liveboxandy/ZX-Interface-1-Renewed-PLCC/ZX Interface 1 New Layout SMD PLCC.jpg

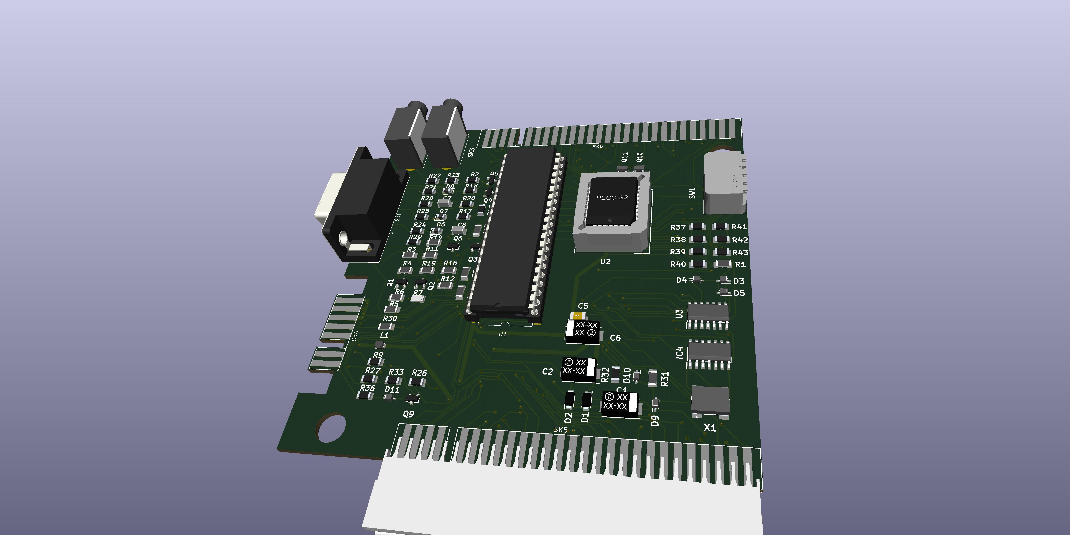
ZX Interface 1 New Layout SMD PLCC.jpg
