liveboxandy/ZX-Interface-1-Renewed-PLCC/ZX Interface 1 New Layout SMD PLCC.csv

Reference | Qty | Value | DNP | Exclude from BOM | Exclude from Board | Exclude from Simulation | Exclude from Position Files | Footprint | Datasheet
C1,C2,C6 | 3 | 47uF 16V |  |  |  |  | ${EXCLUDE_FROM_POS_FILES} | MOD:CAPPM7343X310N | http://www.vishay.com/docs/40002/293d.pdf
C5 | 1 | 47nF |  |  |  |  | ${EXCLUDE_FROM_POS_FILES} | MOD:C1206 | https://componentsearchengine.com/Datasheets/1/C1206C473K5RACTU.pdf
C7,C8 | 2 | 330pF |  |  |  |  | ${EXCLUDE_FROM_POS_FILES} | MOD:CAPC3317X75N | https://componentsearchengine.com/Datasheets/1/C3216C0G2J331J060AA.pdf
D1,D2 | 2 | SS2FH6 |  |  |  |  | ${EXCLUDE_FROM_POS_FILES} | MOD:SODFL3718X108N | http://www.vishay.com/docs/87731/ss2fh6.pdf
D3,D4,D5,D9,D10,D11 | 6 | 1N4148 |  |  |  |  | ${EXCLUDE_FROM_POS_FILES} | MOD:SODFL2512X90N | https://assets.nexperia.com/documents/data-sheet/1N4148_1N4448.pdf,https://www.diodes.com/assets/Datasheets/BAV16W_1N4148W.pdf
D6,D7,D8 | 3 | BZY55C4V3 |  |  |  |  | ${EXCLUDE_FROM_POS_FILES} | MOD:DIOC2012X85N | https://www.taiwansemi.com/assets/uploads/datasheet/BZY55C2V4%20SERIES_E2301.pdf
IC4 | 1 | SN74HCU04DR |  |  |  |  | ${EXCLUDE_FROM_POS_FILES} | MOD:SOIC127P600X175-14N | https://www.ti.com/lit/ds/symlink/sn74hcu04.pdf?ts=1600065682411
L1 | 1 | 22uH 0.41A |  |  |  |  | ${EXCLUDE_FROM_POS_FILES} | MOD:LQH2MCN100K02L | https://psearch.en.murata.com/inductor/product/LQH2MPN220MGR%23.html
Q1,Q2,Q4,Q5 | 4 | BC807-40 |  |  |  |  | ${EXCLUDE_FROM_POS_FILES} | MOD:SOT95P230X110-3N | https://assets.nexperia.com/documents/data-sheet/BC807_SER.pdf
Q3,Q6,Q9 | 3 | BC850C |  |  |  |  | ${EXCLUDE_FROM_POS_FILES} | MOD:BC850C215 | https://assets.nexperia.com/documents/data-sheet/BC849_BC850.pdf
Q10,Q11 | 2 | SST3904 |  |  |  |  | ${EXCLUDE_FROM_POS_FILES} | MOD:SOT95P240X120-3N | https://fscdn.rohm.com/en/products/databook/datasheet/discrete/transistor/bipolar/sst3904hzg-e.pdf
R1,R3,R5,R11,R14,R19,R31 | 7 | 1K0 |  |  |  |  | ${EXCLUDE_FROM_POS_FILES} | MOD:RESC3216X60N | http://componentsearchengine.com/Datasheets/1/CRCW12061K00FKEAC.pdf
R2,R22,R23 | 3 | 330R |  |  |  |  | ${EXCLUDE_FROM_POS_FILES} | MOD:RESC3116X65N
R4,R6,R8,R16 | 4 | 3K9 |  |  |  |  | ${EXCLUDE_FROM_POS_FILES} | MOD:RESC3216X60N | http://www.vishay.com/docs/20035/dcrcwe3.pdf
R7 | 1 | 47R |  |  |  |  | ${EXCLUDE_FROM_POS_FILES} | MOD:RCC1206_e3 | https://www.vishay.com/docs/20066/rcce3.pdf
R9,R21,R25,R26,R27,R33,R36,R37,R38,R39,R40,R41,R42,R43 | 14 | 10K |  |  |  |  | ${EXCLUDE_FROM_POS_FILES} | MOD:RESC3116X65N | http://www.te.com/commerce/DocumentDelivery/DDEController?Action=showdoc
R10 | 1 | 2K2 |  |  |  |  | ${EXCLUDE_FROM_POS_FILES} | MOD:RESC3216X60N | http://www.vishay.com/docs/20035/dcrcwe3.pdf
R12,R15 | 2 | 12K |  |  |  |  | ${EXCLUDE_FROM_POS_FILES} | MOD:RESC3216X60N | https://componentsearchengine.com/Datasheets/1/CRCW120612K4FKEAC.pdf
R13,R18,R32 | 3 | 680R |  |  |  |  | ${EXCLUDE_FROM_POS_FILES} | MOD:RESC3116X65N
R17,R20 | 2 | 2K7 |  |  |  |  | ${EXCLUDE_FROM_POS_FILES} | MOD:RESC3116X65N
R24 | 1 | 4K7 |  |  |  |  | ${EXCLUDE_FROM_POS_FILES} | MOD:RESC3116X65N | http://www.te.com/commerce/DocumentDelivery/DDEController?Action=showdoc
R28,R29 | 2 | 6K8 |  |  |  |  | ${EXCLUDE_FROM_POS_FILES} | MOD:RESC3116X65N | https://componentsearchengine.com/Datasheets/1/CRG1206F6K8.pdf
R30 | 1 | 270R |  |  |  |  | ${EXCLUDE_FROM_POS_FILES} | MOD:RESC3216X60N | https://componentsearchengine.com/Datasheets/1/CRCW1206270RFKEA.pdf
SK1 | 1 | DE9_Receptacle |  |  |  |  | ${EXCLUDE_FROM_POS_FILES} | MOD:DSUB-9_Female_Horizontal_P2.77x2.84mm_EdgePinOffset4.94mm_Housed_MountingHolesOffset7.48mm | ~
SK2,SK3 | 2 | MJ-3502N |  |  |  |  | ${EXCLUDE_FROM_POS_FILES} | MOD:MJ3502N | https://www.cui.com/product/resource/mj-3502n.pdf
SK4 | 1 | Microdrive |  |  |  |  | ${EXCLUDE_FROM_POS_FILES} | MOD:ZX_MD_Edge_Connector
SK5 | 1 | ZX Spectrum |  |  |  |  | ${EXCLUDE_FROM_POS_FILES} | MOD:ZX_Spectrum_BUS_Edge_Connector
SK6 | 1 | ZX Expansion |  |  |  |  | ${EXCLUDE_FROM_POS_FILES} | MOD:ZX_Expansion_BUS_Edge_Connector
SW1 | 1 | SW_DIP_x05 |  |  |  |  | ${EXCLUDE_FROM_POS_FILES} | MOD:A6FR5104 | https://omronfs.omron.com/en_US/ecb/products/pdf/en-a6fr.pdf
U1 | 1 | LA15-302 |  |  |  |  | ${EXCLUDE_FROM_POS_FILES} | MOD:DIP-40_W15.24mm | LA 15-302 Custom ULA
U2 | 1 | SST39SF040 |  |  |  |  | ${EXCLUDE_FROM_POS_FILES} | MOD:MC32PLCC | http://ww1.microchip.com/downloads/en/DeviceDoc/20005022C.pdf
U3 | 1 | 74LS27 |  |  |  |  | ${EXCLUDE_FROM_POS_FILES} | MOD:SOIC127P600X175-14N | http://www.ti.com/lit/gpn/SN74LS27
X1 | 1 | 8Mhz |  |  |  |  | ${EXCLUDE_FROM_POS_FILES} | MOD:830202129201 | https://www.we-online.com/catalog/datasheet/830202129201.pdf
