liveboxandy/ZX-Interface-1-Renewed-PLCC/STPS/SN74HCU04DR.stp

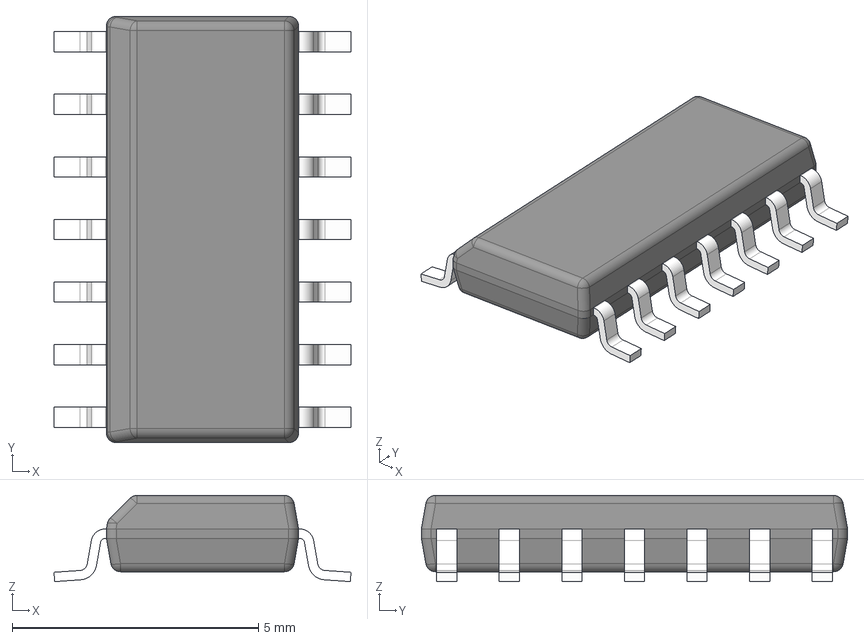
[picture p3: CAD file, 2026-10-28]
STPS/SN74HCU04DR.stp
6.03 x 8.65 x 1.75 mm
BODY-SO
LEAD-SO x 14
PIN1-ID
