liveboxandy/ZX-Interface-1-Renewed-PLCC/ZX Interface 1 New Layout SMD PLCC.step

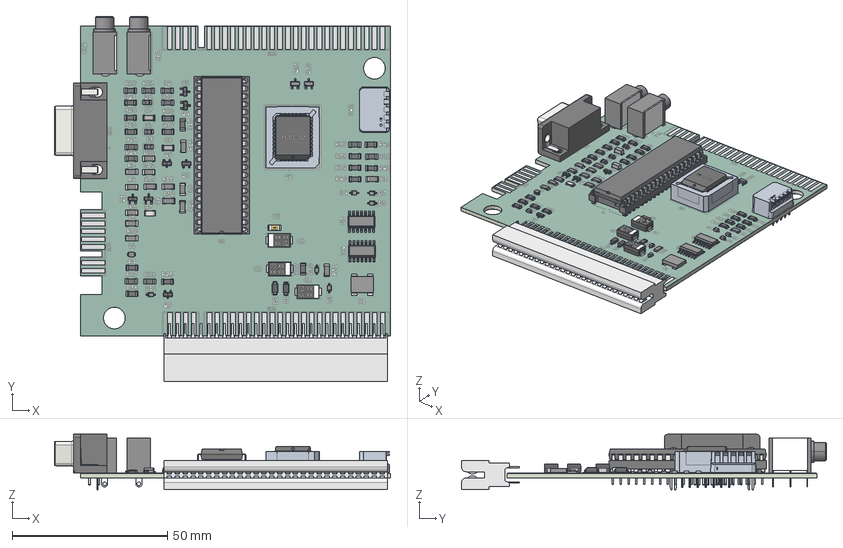
[picture p4: CAD file, 2026-10-28]
ZX Interface 1 New Layout SMD PLCC.step
108.4 x 117.7 x 17.9 mm
term1 x 28
term2 x 28
BODY-SO x 2
LEAD-SO x 28
PIN1-ID x 2
D25-CRCW1206 e3 x 15
SOT23 lower body x 7
SOT23 Lead x 21
SOT23 Upper body x 7
C-5435802-4
CCS_CCSTDNOS_1206_L3.40W1.80T1.75B0.75
PinKIdent x 6
PinK x 6
PinA x 6
DIP-40_W15.24mm
DIP_40_W1524mm_Socket
C3216C0G1H104J160AE x 2
SMF Package x 2
MJ-3502N x 2
PinsArrayL x 2
FilletPinR x 2
293D D-CASE x 3
LQH2MCN120K02L
DSUB-9_Female_Horizontal_P2.77x2.84mm_EdgePinOffset4.94mm_Housed_ MountingHolesOffset7.48mm
Pins
ZX 2A3D_copper
ZX 2A3D_pad
ZX 2A3D_via
ZX 2A3D_silkscreen x 2
ZX 2A3D_soldermask x 2
ZX 2A3D_PCB
