liveboxandy/ZX-Interface-1-Renewed-PLCC/STPS/DSUB-9_Female_Horizontal_P2.77x2.84mm_EdgePinOffset4.94mm_Housed_MountingHolesOffset7.48mm.step

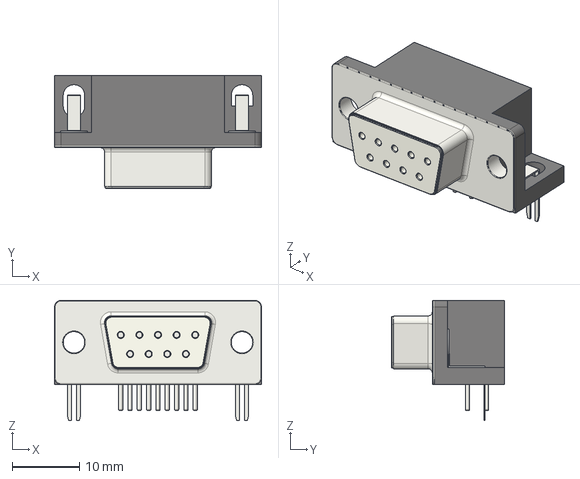
[picture p5: CAD file, 2026-10-28]
STPS/DSUB-9_Female_Horizontal_P2.77x2.84mm_EdgePinOffset4.94mm_Housed_MountingHolesOffset7.48mm.step
30.8 x 16.9 x 17.9 mm
