liveboxandy/ZX-Interface-1-Renewed-PLCC/STPS/PLCC32 Skt 1571540-1.stp

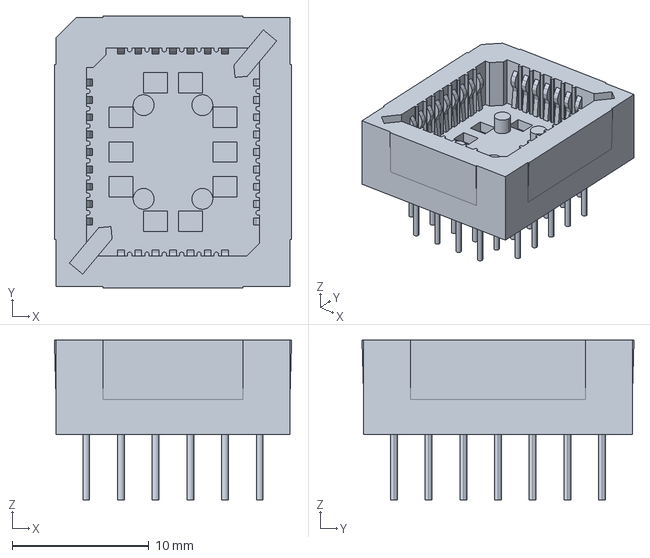
[picture p6: CAD file, 2026-10-28]
STPS/PLCC32 Skt 1571540-1.stp
17.4 x 19.9 x 11.7 mm
