liveboxandy/ZX-Interface-1-Renewed-PLCC/STPS/CRCW12062K20FKEA.stp

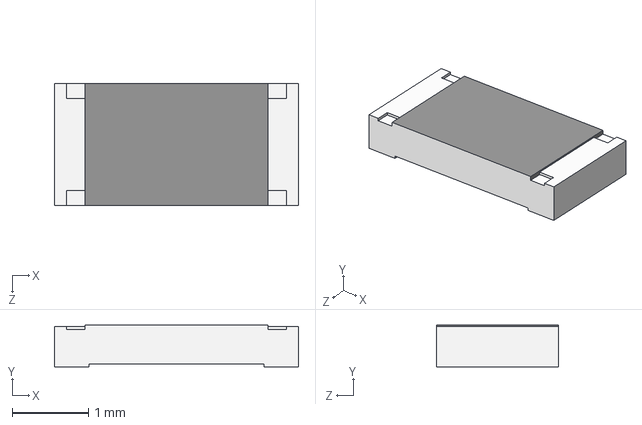
[picture p7: CAD file, 2026-10-28]
STPS/CRCW12062K20FKEA.stp
3.20 x 0.55 x 1.60 mm
