liveboxandy/ZX-Interface-1-Renewed-PLCC/STPS/DIP-40_W15.24mm.step

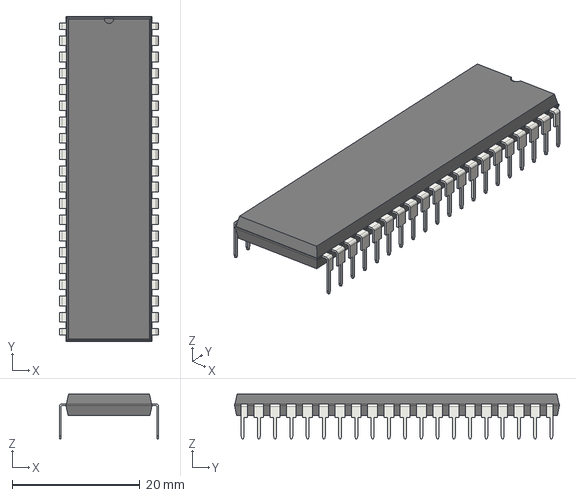
[picture p8: CAD file, 2026-10-28]
STPS/DIP-40_W15.24mm.step
15.5 x 50.8 x 6.98 mm
