liveboxandy/ZX-Interface-1-Renewed-PLCC/STPS/C3216C0G2J331J060AA.stp

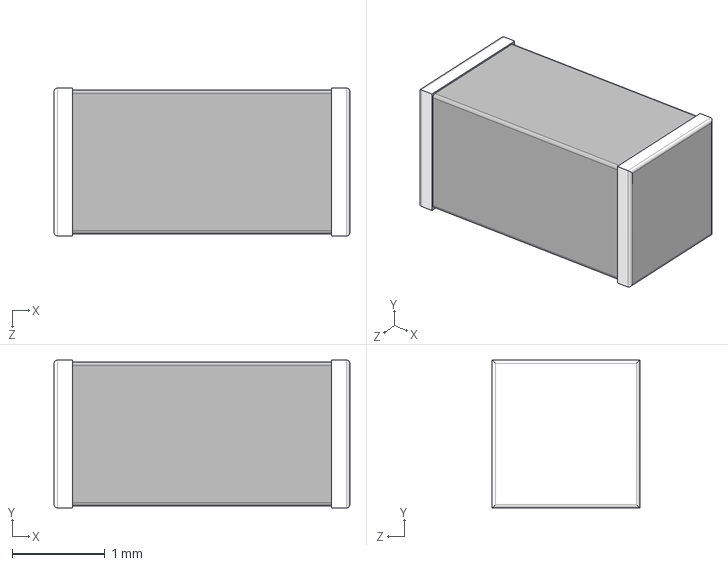
[picture p9: CAD file, 2026-10-28]
STPS/C3216C0G2J331J060AA.stp
3.20 x 1.60 x 1.60 mm
