liveboxandy/ZX-Interface-1-Renewed-PLCC/STPS/BAT20JFILM.stp

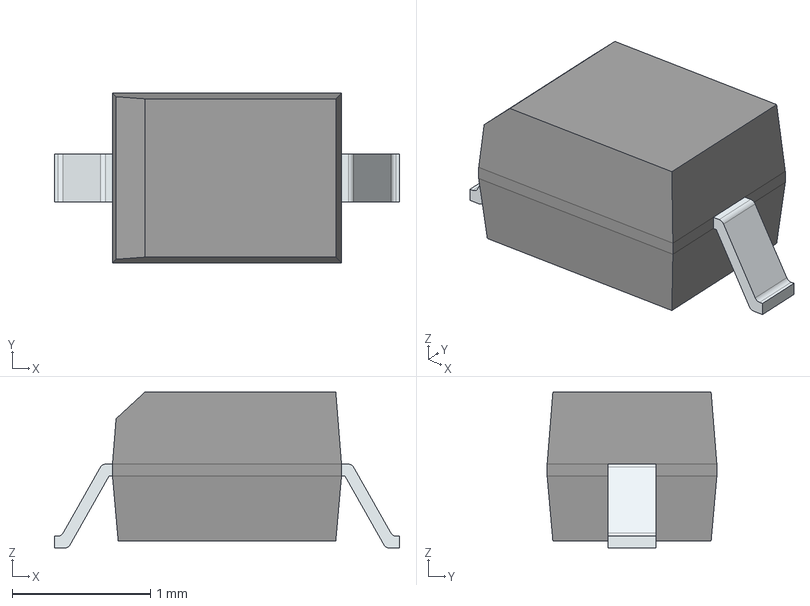
[picture p10: CAD file, 2026-10-28]
STPS/BAT20JFILM.stp
2.50 x 1.23 x 1.13 mm
FilletPinL
FilletPinR
