liveboxandy/ZX-Interface-1-Renewed-PLCC/STPS/SN74HCU04PW.stp

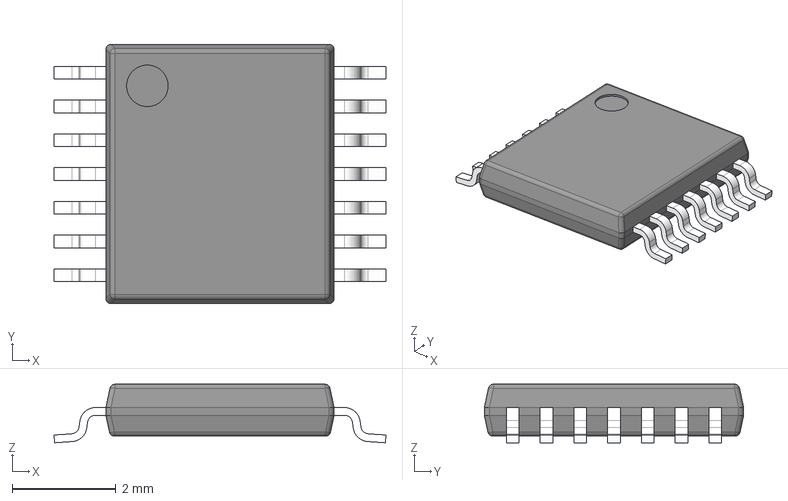
[picture p11: CAD file, 2026-10-28]
STPS/SN74HCU04PW.stp
6.40 x 5.00 x 1.13 mm
BODY-TSSOP
LEAD-TSSOP x 14
PIN1
