liveboxandy/ZX-Interface-1-Renewed-PLCC/STPS/SST39SF040-70-4C-PHE.stp

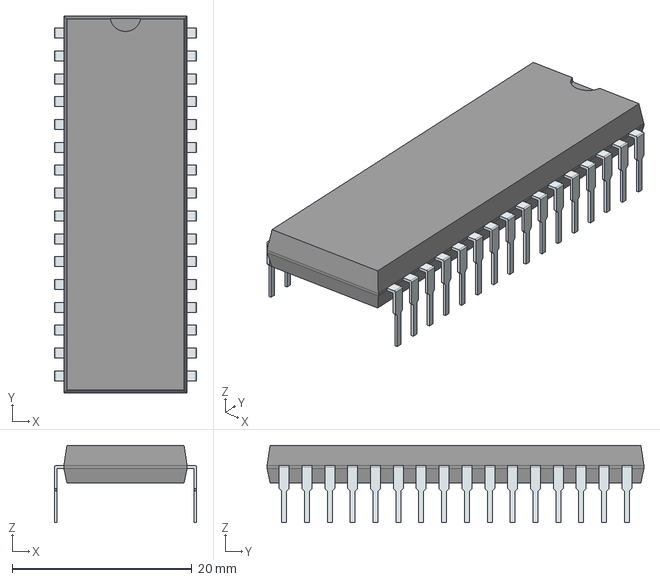
[picture p12: CAD file, 2026-10-28]
STPS/SST39SF040-70-4C-PHE.stp
15.8 x 41.9 x 8.58 mm
PinsArrayLR
