liveboxandy/ZX-Interface-1-Renewed-PLCC/STPS/CRGH1206F330R.stp

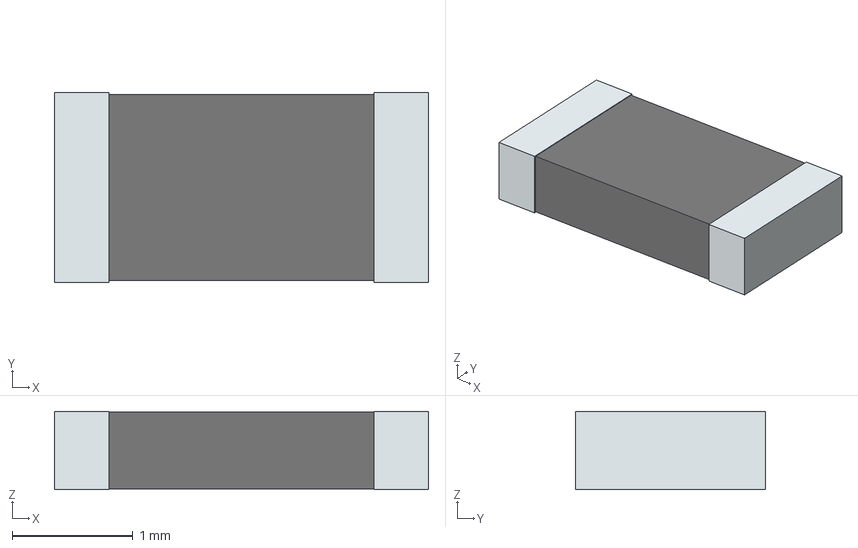
[picture p13: CAD file, 2026-10-28]
STPS/CRGH1206F330R.stp
3.10 x 1.57 x 0.65 mm
term1
term2
