liveboxandy/ZX-Interface-1-Renewed-PLCC/STPS/CRG1206F6K8.stp

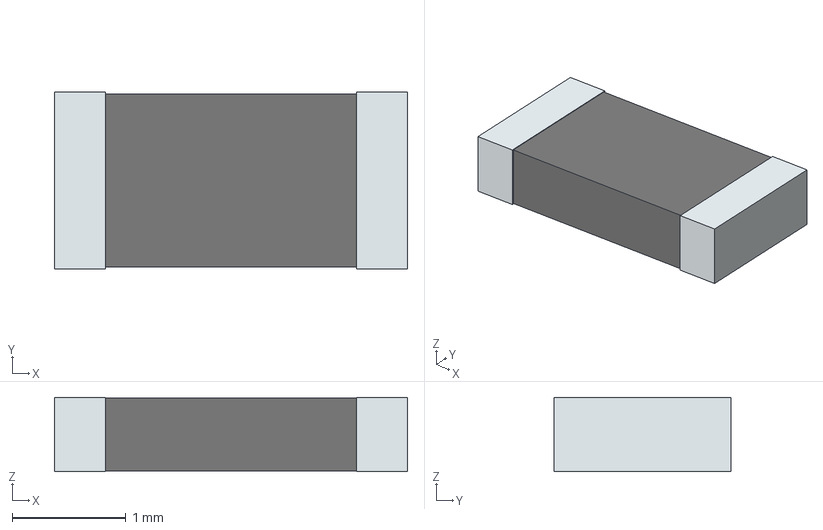
[picture p14: CAD file, 2026-10-28]
STPS/CRG1206F6K8.stp
3.10 x 1.55 x 0.65 mm
term1
term2
