liveboxandy/ZX-Interface-1-Renewed-PLCC/STPS/C1206C473K5RACTU.stp

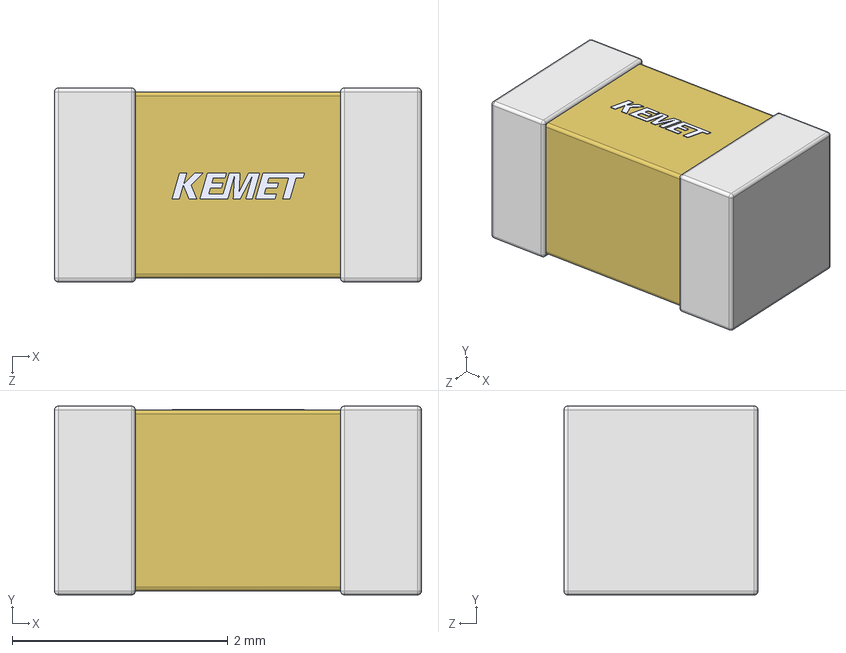
[picture p15: CAD file, 2026-10-28]
STPS/C1206C473K5RACTU.stp
3.40 x 1.75 x 1.80 mm
