liveboxandy/ZX-Interface-1-Renewed-PLCC/STPS/C1206C473J4REC7210.stp

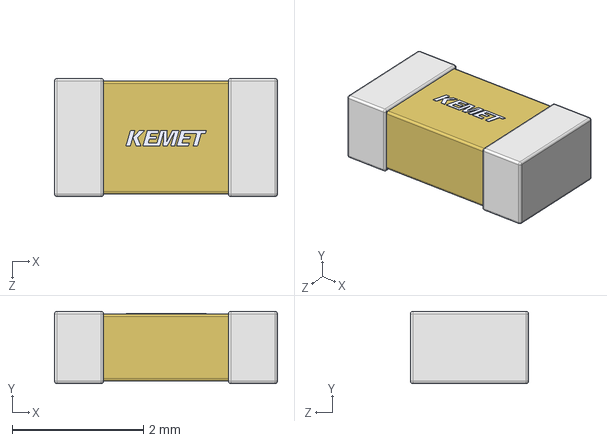
[picture p16: CAD file, 2026-10-28]
STPS/C1206C473J4REC7210.stp
3.40 x 1.10 x 1.80 mm
