liveboxandy/ZX-Interface-1-Renewed-PLCC/STPS/56 Way RightAngle.stp

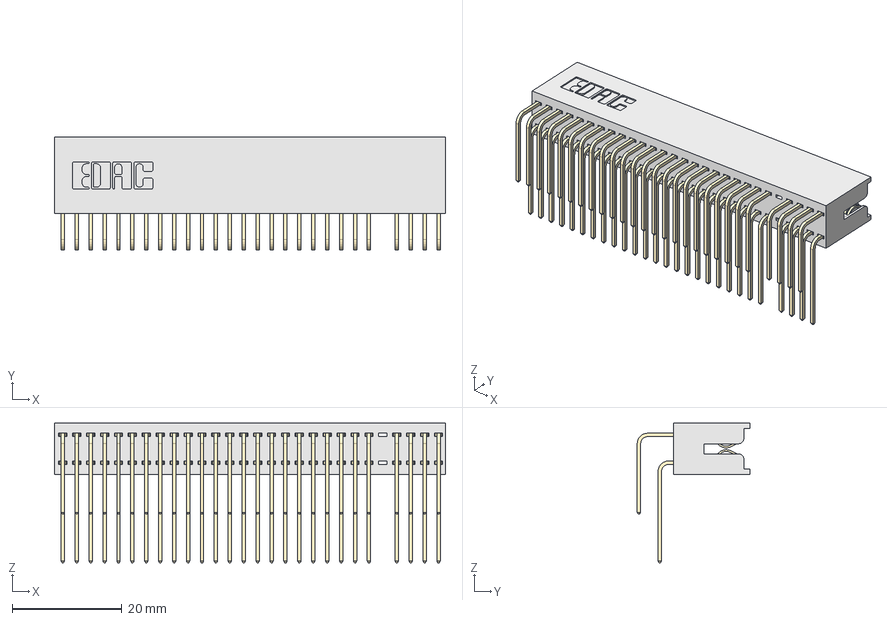
[picture p17: CAD file, 2026-10-28]
STPS/56 Way RightAngle.stp
71.4 x 20.6 x 25.5 mm
345-292-001_558 559 Tail - 020
345-292-001_559 Tail - 021
345-292-001_558 559 Tail - 021
345-292-001_558 559 Tail - 022
345-292-001_559 Tail - 022
345-292-001_559 Tail - 023
345-292-001_558 559 Tail - 023
345-292-001_559 Tail - 024
345-292-001_558 559 Tail - 024
345-292-001_558 559 Tail - 025
345-292-001_558 559 Tail - 026
345-292-001_558 559 Tail - 027
345-292-001_558 559 Tail - 028
345-292-001_558 559 Tail - 029
345-292-001_558 559 Tail - 030
345-292-001_558 559 Tail - 031
345-292-001_558 559 Tail - 032
345-292-001_558 559 Tail - 033
345-292-001_558 559 Tail - 034
345-292-001_558 559 Tail - 035
345-292-001_558 559 Tail - 036
345-292-001_558 559 Tail - 037
345-292-001_558 559 Tail - 038
345-292-001_558 559 Tail - 039
345-292-001_558 559 Tail - 040
345-292-001_558 559 Tail - 041
345-292-001_558 559 Tail - 042
345-292-001_558 559 Tail - 044
345-292-001_558 559 Tail - 045
345-292-001_558 559 Tail - 046
345-292-001_558 559 Tail - 047
345-292-001_559 Tail - 025
345-292-001_559 Tail - 026
345-292-001_559 Tail - 027
345-292-001_559 Tail - 028
345-292-001_559 Tail - 029
345-292-001_559 Tail - 030
345-292-001_559 Tail - 031
345-292-001_559 Tail - 032
345-292-001_559 Tail - 033
345-292-001_559 Tail - 034
345-292-001_559 Tail - 035
345-292-001_559 Tail - 036
345-292-001_559 Tail - 037
345-292-001_559 Tail - 038
345-292-001_559 Tail - 039
345-292-001_559 Tail - 040
345-292-001_559 Tail - 041
345-292-001_559 Tail - 042
345-292-001_559 Tail - 043
345-292-001_559 Tail - 045
345-292-001_559 Tail - 046
345-292-001_559 Tail - 047
345-292-001_559 Tail - 048
