liveboxandy/ZX-Interface-1-Renewed-PLCC/STPS/XM3B-0922-502.stp

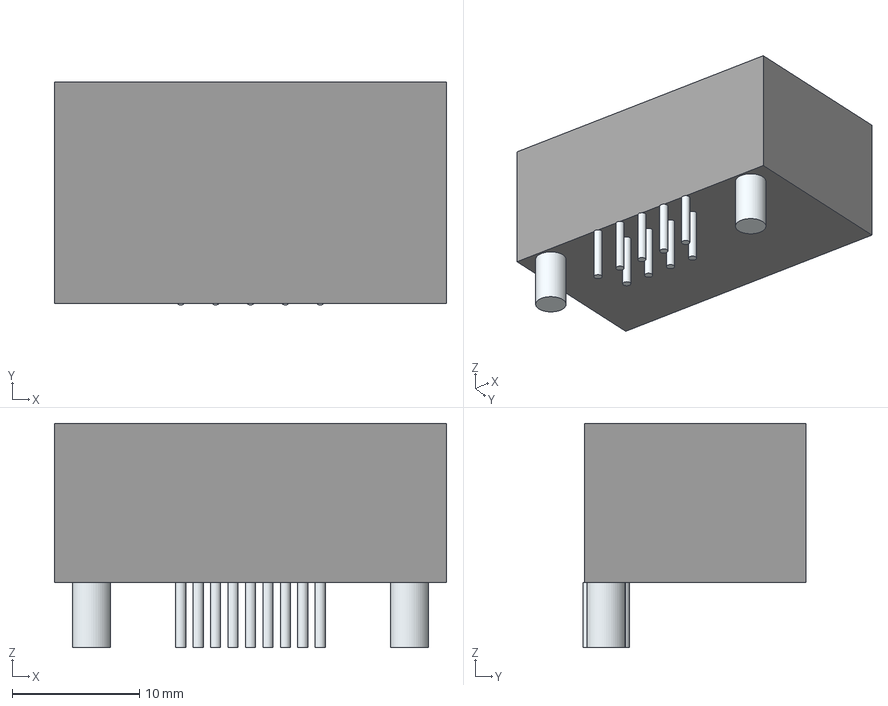
[picture p18: CAD file, 2026-10-28]
STPS/XM3B-0922-502.stp
30.8 x 17.5 x 17.6 mm
Leads
