liveboxandy/ZX-Interface-1-Renewed-PLCC/STPS/NE555DR.stp

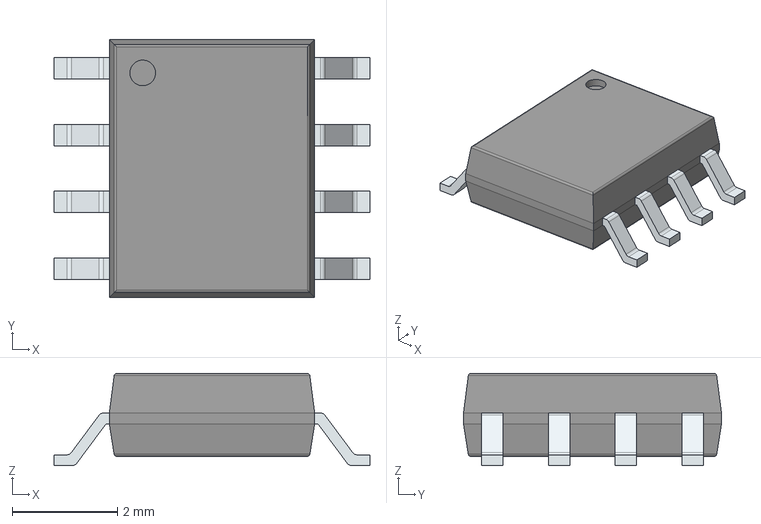
[picture p19: CAD file, 2026-10-28]
STPS/NE555DR.stp
6.00 x 4.90 x 1.75 mm
PinsArrayLR
