liveboxandy/ZX-Interface-1-Renewed-PLCC/STPS/SS2FH6-M3_H.stp

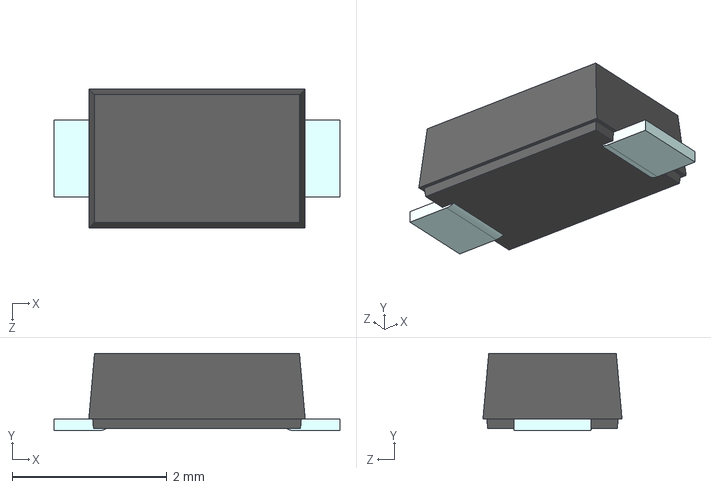
[picture p20: CAD file, 2026-10-28]
STPS/SS2FH6-M3_H.stp
3.70 x 1 x 1.80 mm
