liveboxandy/ZX-Interface-1-Renewed-PLCC/STPS/DIP-32_W15.24mm.step

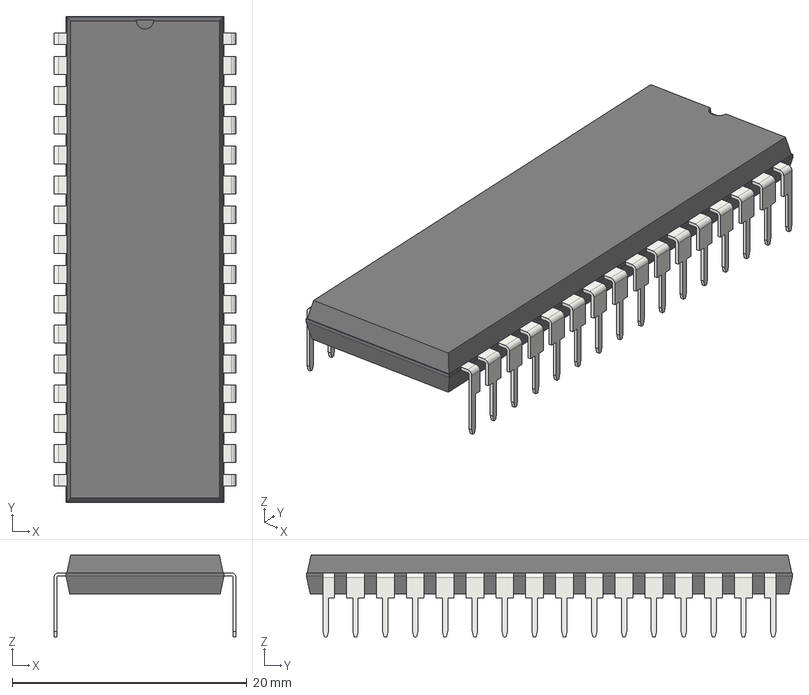
[picture p21: CAD file, 2026-10-28]
STPS/DIP-32_W15.24mm.step
15.5 x 41.4 x 6.98 mm
