liveboxandy/ZX-Interface-1-Renewed-PLCC/STPS/293D476X9016D2TE3.stp

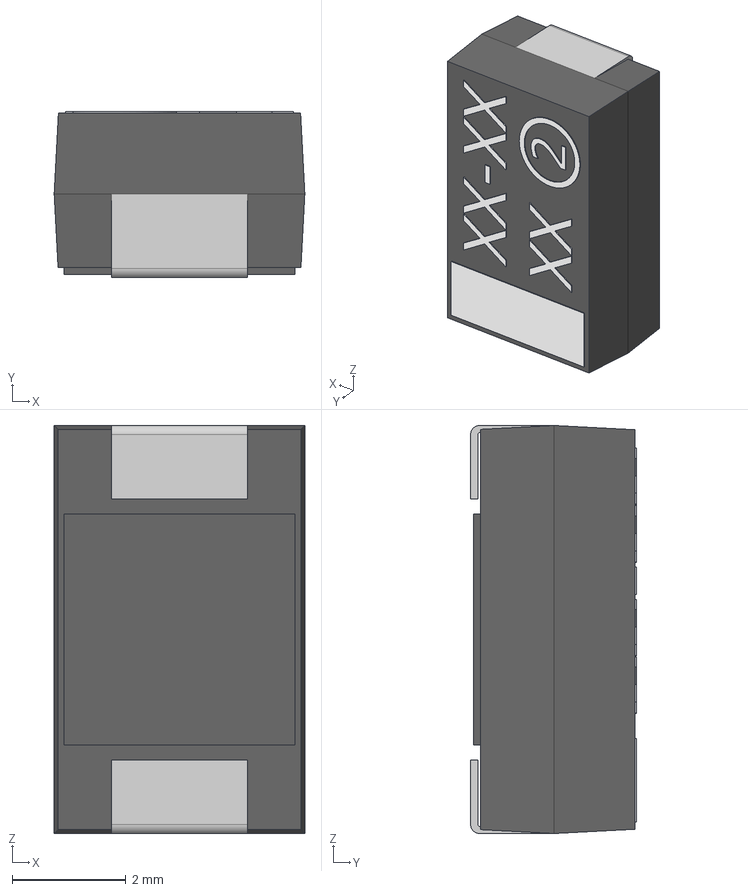
[picture p22: CAD file, 2026-10-28]
STPS/293D476X9016D2TE3.stp
4.42 x 2.92 x 7.19 mm
