liveboxandy/ZX-Interface-1-Renewed-PLCC/STPS/SST39SF040-70-4I-WHE-T.stp

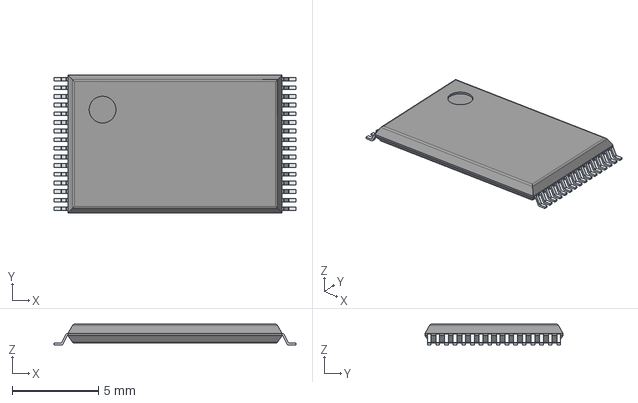
[picture p23: CAD file, 2026-10-28]
STPS/SST39SF040-70-4I-WHE-T.stp
14.0 x 8.00 x 1.20 mm
PinsArrayLR
