liveboxandy/ZX-Interface-1-Renewed-PLCC/STPS/BC807-40,215.stp

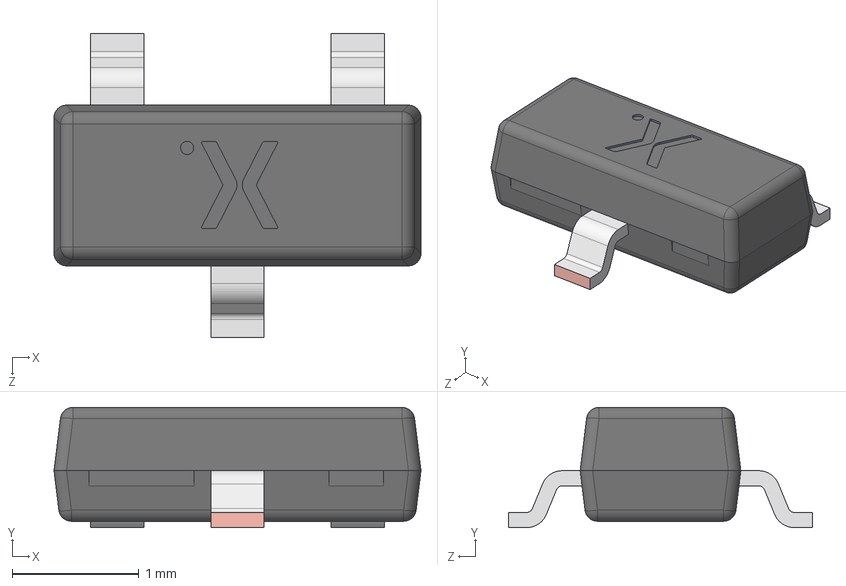
[picture p24: CAD file, 2026-10-28]
STPS/BC807-40,215.stp
2.90 x 0.95 x 2.40 mm
SOT23 lower body
SOT23 Lead x 3
SOT23 Upper body
