liveboxandy/ZX-Interface-1-Renewed-PLCC/STPS/SST3904HZGT116.stp

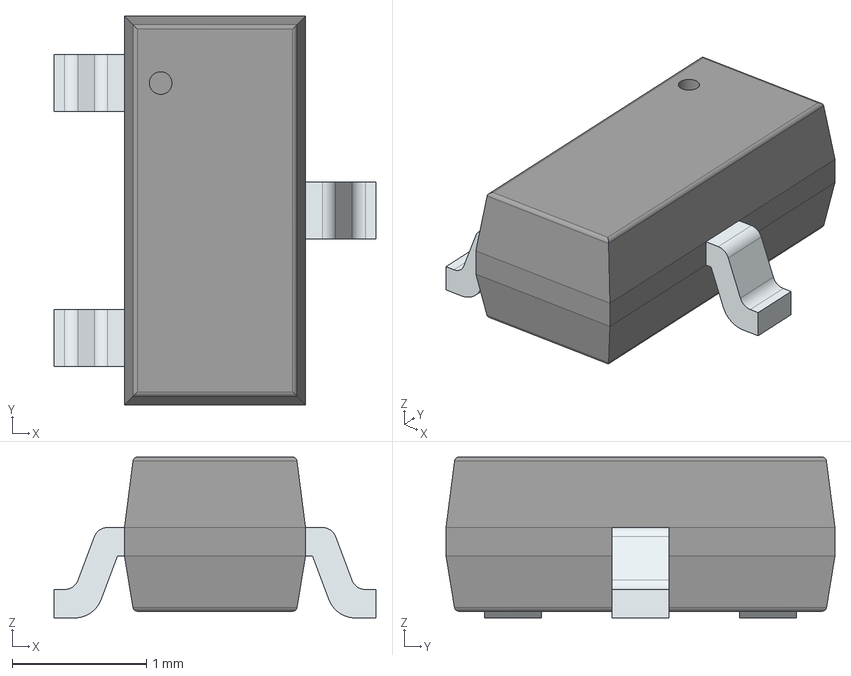
[picture p25: CAD file, 2026-10-28]
STPS/SST3904HZGT116.stp
2.40 x 2.90 x 1.20 mm
PinsArrayL
FilletPinR
