liveboxandy/ZX-Interface-1-Renewed-PLCC/STPS/LQH2MPN220MGRL.stp

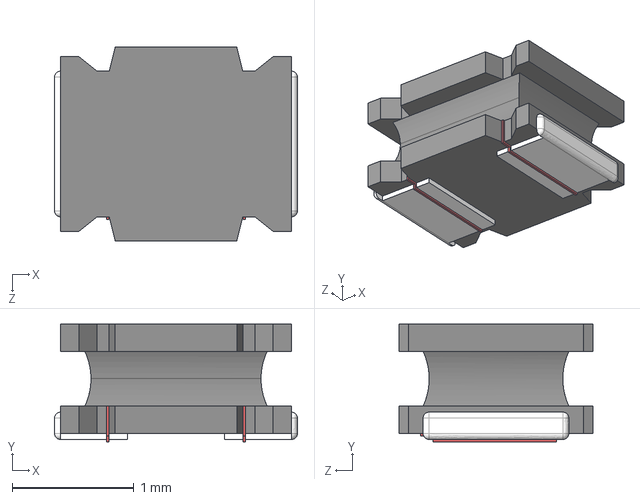
[picture p26: CAD file, 2026-10-28]
STPS/LQH2MPN220MGRL.stp
2.00 x 0.97 x 1.60 mm
