liveboxandy/ZX-Interface-1-Renewed-PLCC/STPS/DIP-40_W15.24mm_Socket.step

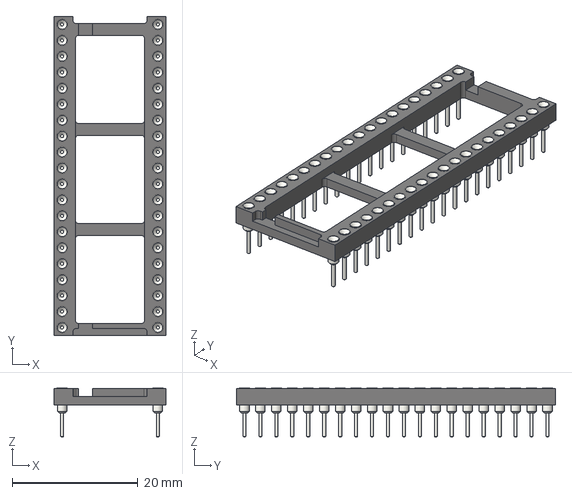
[picture p27: CAD file, 2026-10-28]
STPS/DIP-40_W15.24mm_Socket.step
17.8 x 50.8 x 7.79 mm
