liveboxandy/ZX-Interface-1-Renewed-PLCC/STPS/BZY55C4V3_RBG.stp

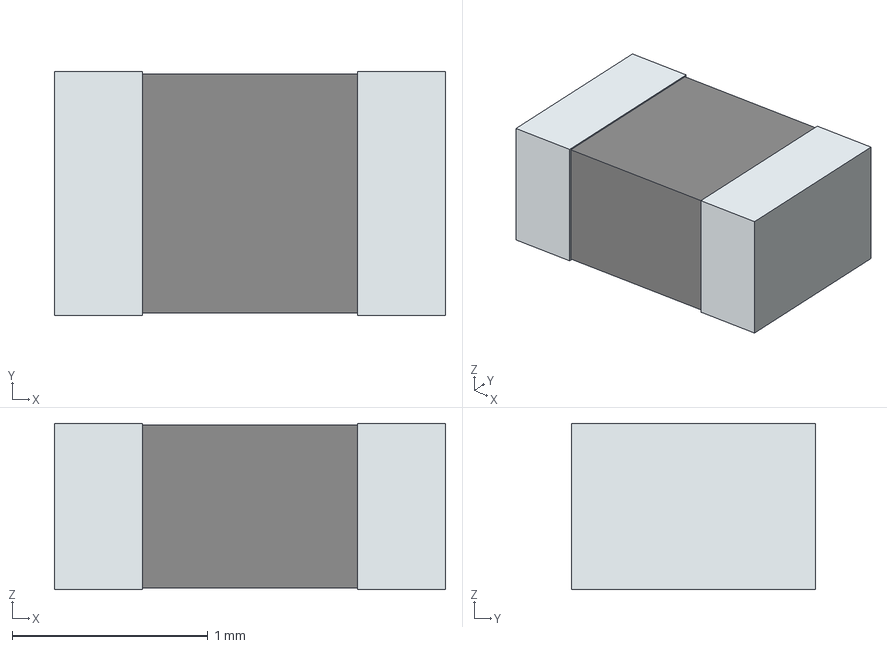
[picture p28: CAD file, 2026-10-28]
STPS/BZY55C4V3_RBG.stp
2.00 x 1.25 x 0.85 mm
term1
term2
