liveboxandy/ZX-Interface-1-Renewed-PLCC/STPS/56 Way Horizontal.stp

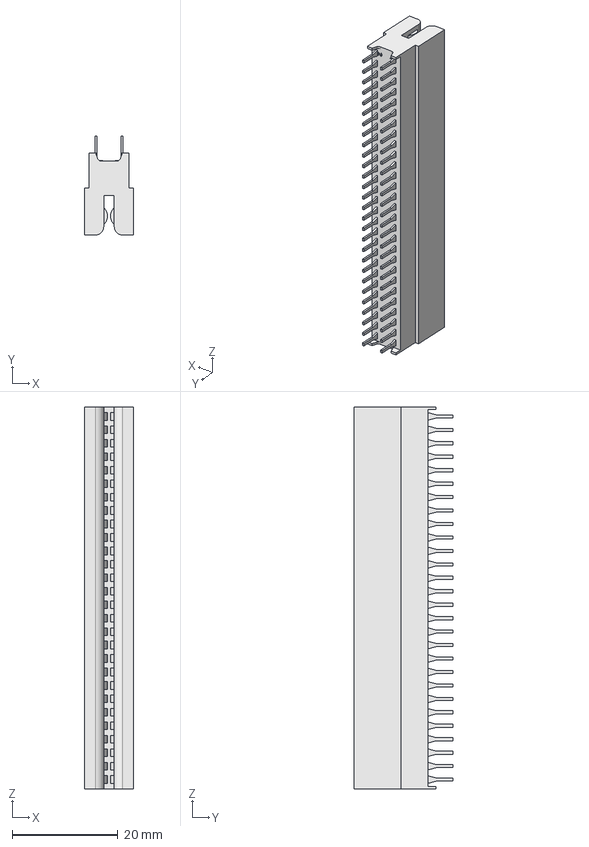
[picture p29: CAD file, 2026-10-28]
STPS/56 Way Horizontal.stp
9.35 x 18.7 x 72.1 mm
