liveboxandy/ZX-Interface-1-Renewed-PLCC/STPS/MJ-3502N.stp

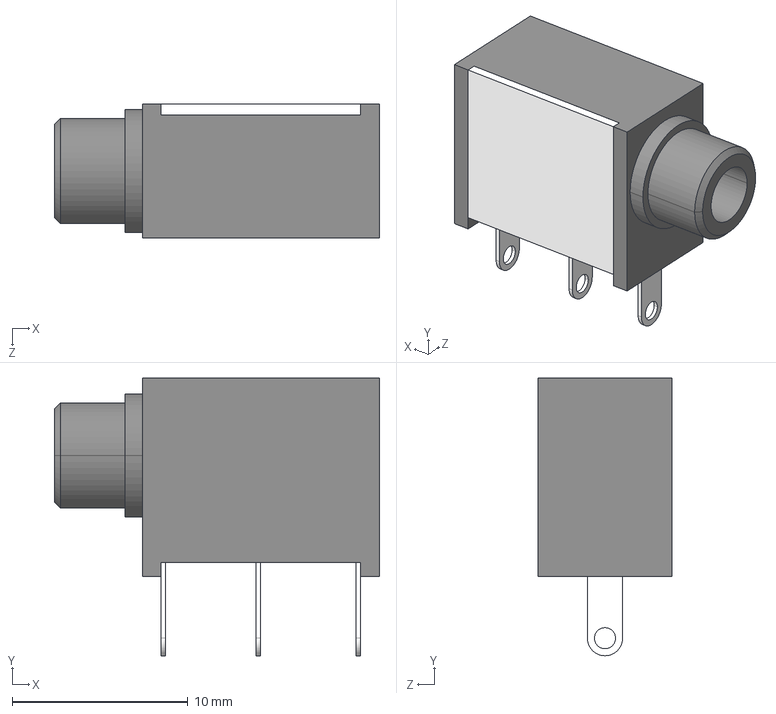
[picture p30: CAD file, 2026-10-28]
STPS/MJ-3502N.stp
18.5 x 15.8 x 7.60 mm
