liveboxandy/ZX-Interface-1-Renewed-PLCC/STPS/5 Position Piano A6FR.stp

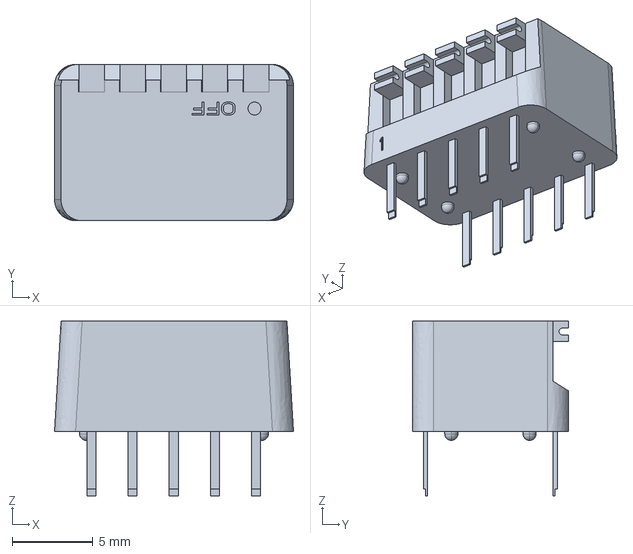
[picture p31: CAD file, 2026-10-28]
STPS/5 Position Piano A6FR.stp
14.8 x 9.66 x 10.8 mm
