liveboxandy/ZX-Interface-1-Renewed-PLCC/STPS/1N4148WS.stp

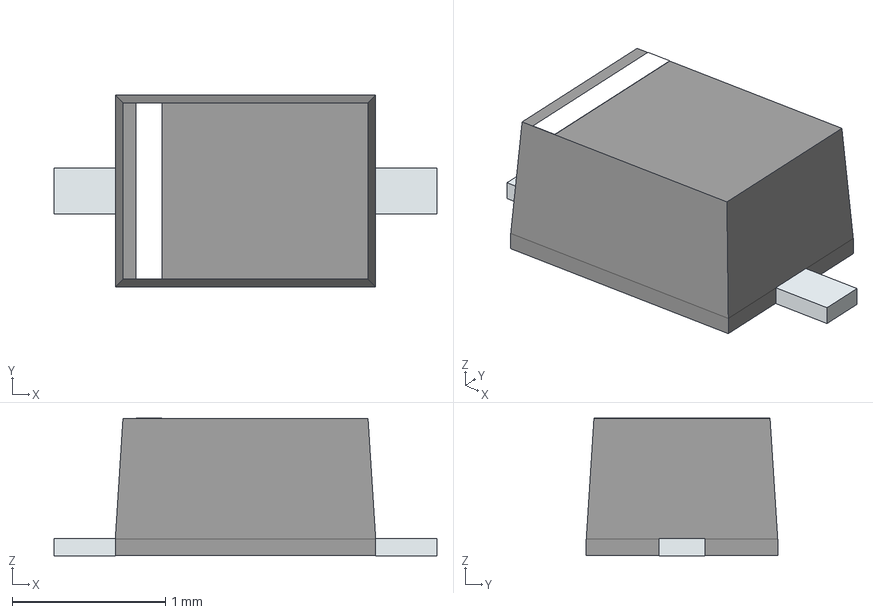
[picture p32: CAD file, 2026-10-28]
STPS/1N4148WS.stp
2.50 x 1.25 x 0.9 mm
PinKIdent
PinK
PinA
