liveboxandy/ZX-Interface-1-Renewed-PLCC/STPS/plcc32_p1-27_l14-05_w11-51.stp

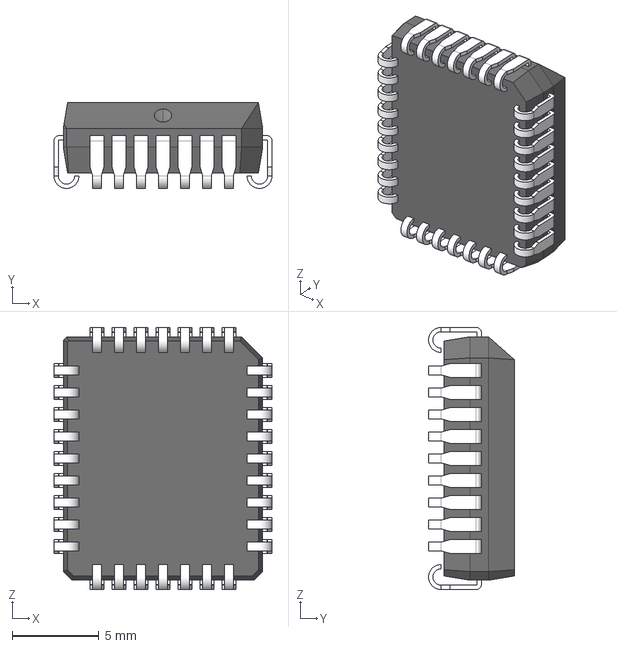
[picture p33: CAD file, 2026-10-28]
STPS/plcc32_p1-27_l14-05_w11-51.stp
12.6 x 4.96 x 15.1 mm
