liveboxandy/ZX-Interface-1-Renewed-PLCC/STPS/MC-32PLCC.stp

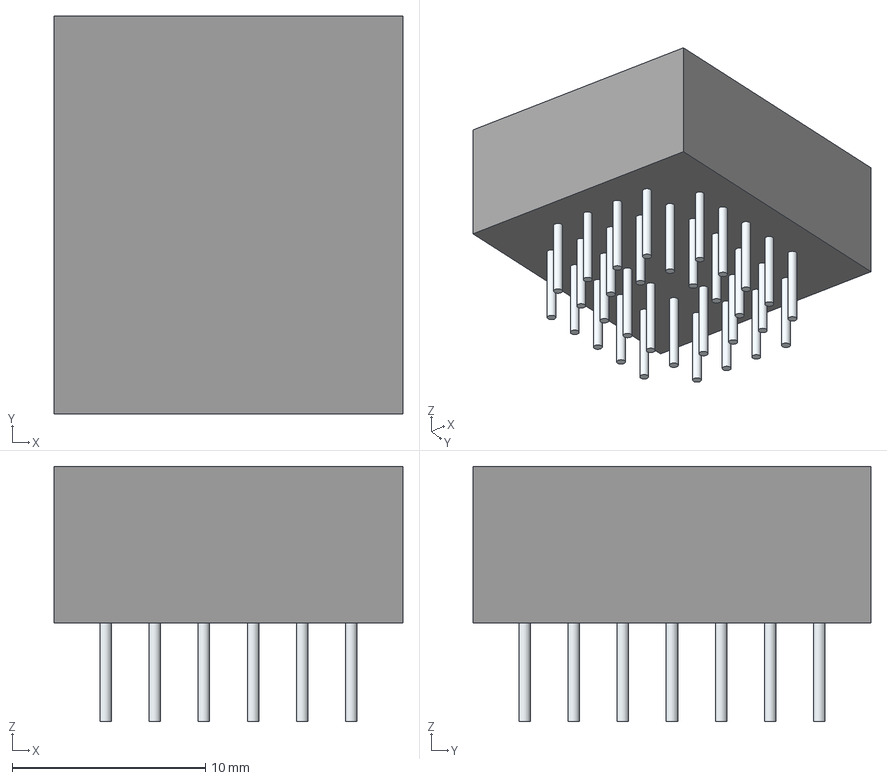
[picture p34: CAD file, 2026-10-28]
STPS/MC-32PLCC.stp
18.0 x 20.6 x 13.2 mm
Leads
