liveboxandy/ZX-Interface-1-Renewed-PLCC/STPS/DIP-32_W15.24mm_Socket.step

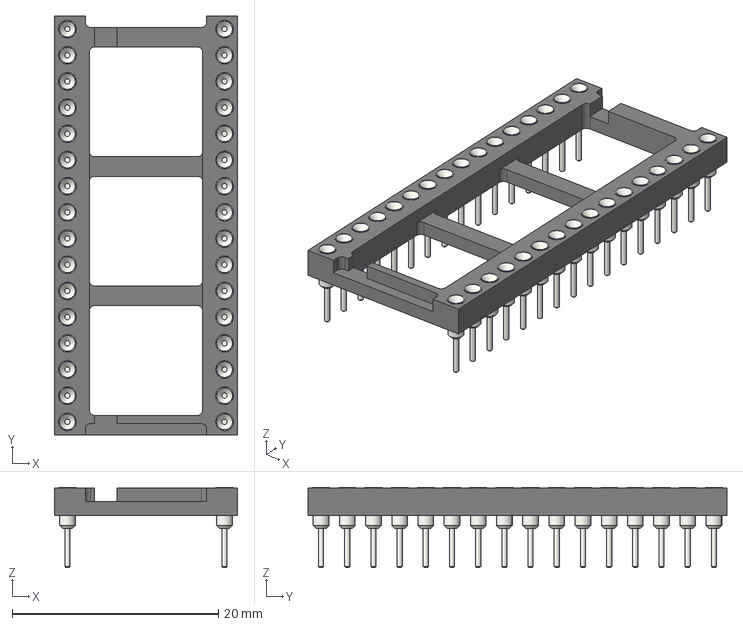
[picture p35: CAD file, 2026-10-28]
STPS/DIP-32_W15.24mm_Socket.step
17.8 x 40.6 x 7.79 mm
