liveboxandy/ZX-Interface-1-Renewed-PLCC/(list of files, cad)

Other CAD files:
STPS/CRGS1206J4K7.stp
STPS/CRG1206F10K.stp
STPS/CRGH1206F680R.stp
STPS/CRGH1206F2K7.stp
STPS/830202129201.stp
STPS/RCC120647R0FKEA.stp
