liveboxandy/ZX-Interface-1-Renewed-PLCC/ZX Interface 1 New Layout SMD PLCC.pdf

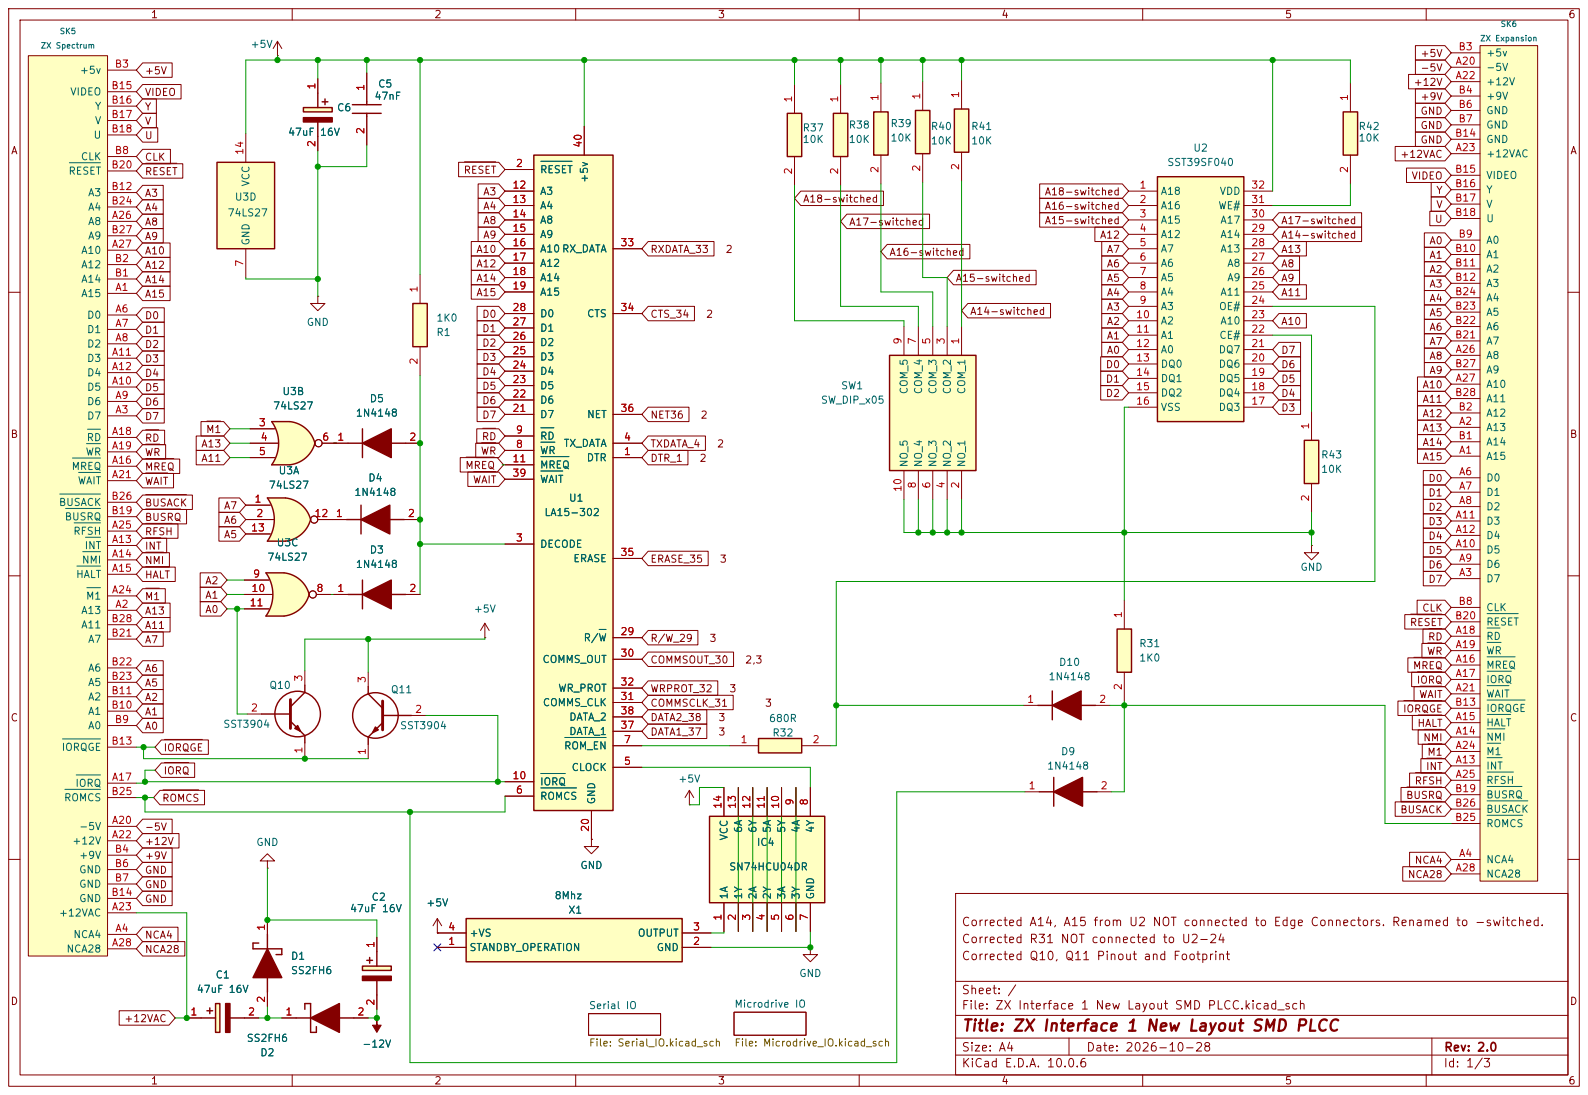
[picture p36: page 1]

IORQ
IORQGE NMI HALT WAIT

Corrected A14, A15 from U2 NOT connected to Edge Connectors. Renamed to -switched. Microdrive IO

Corrected R31 NOT connected to U2-24
Corrected Q10, Q11 Pinout and Footprint

Sheet: /
File: ZX Interface 1 New Layout SMD PLCC.kicad_sch
Title: ZX Interface 1 New Layout SMD PLCC
KiCad E.D.A. 10.0.6

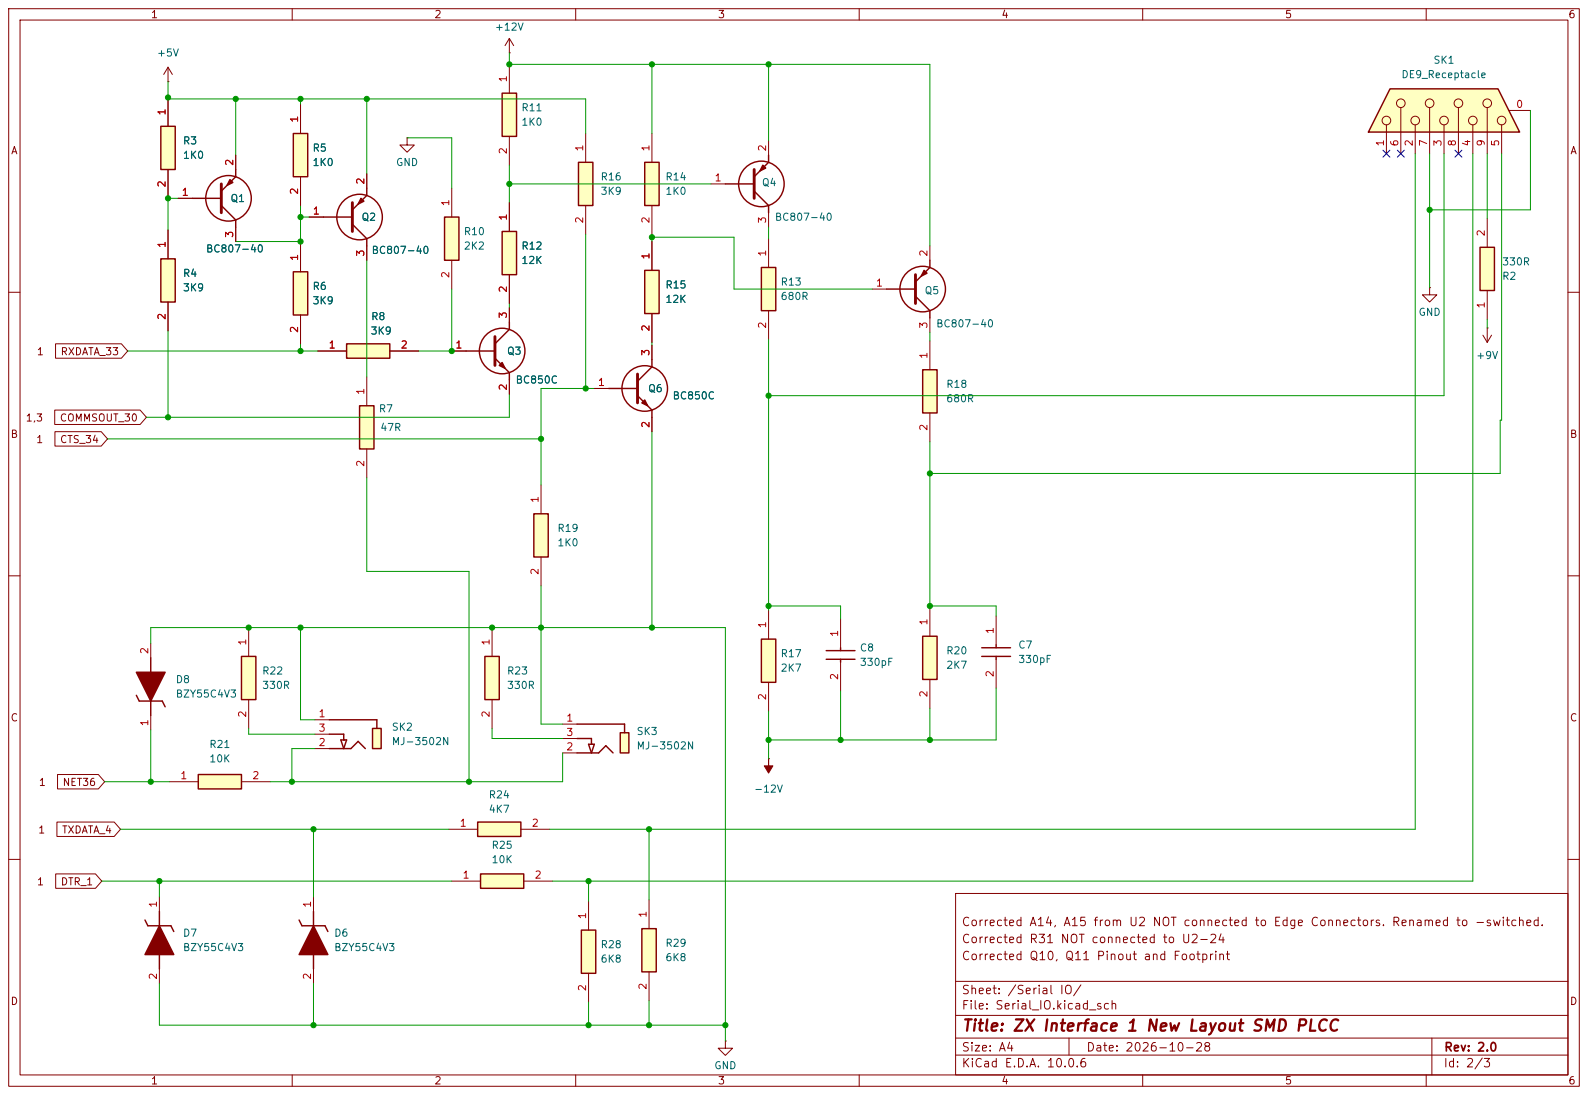
[picture p37: page 2]

Corrected A14, A15 from U2 NOT connected to Edge Connectors. Renamed to -switched.
Corrected R31 NOT connected to U2-24
Corrected Q10, Q11 Pinout and Footprint

Sheet: /Serial IO/
File: Serial_IO.kicad_sch
Title: ZX Interface 1 New Layout SMD PLCC

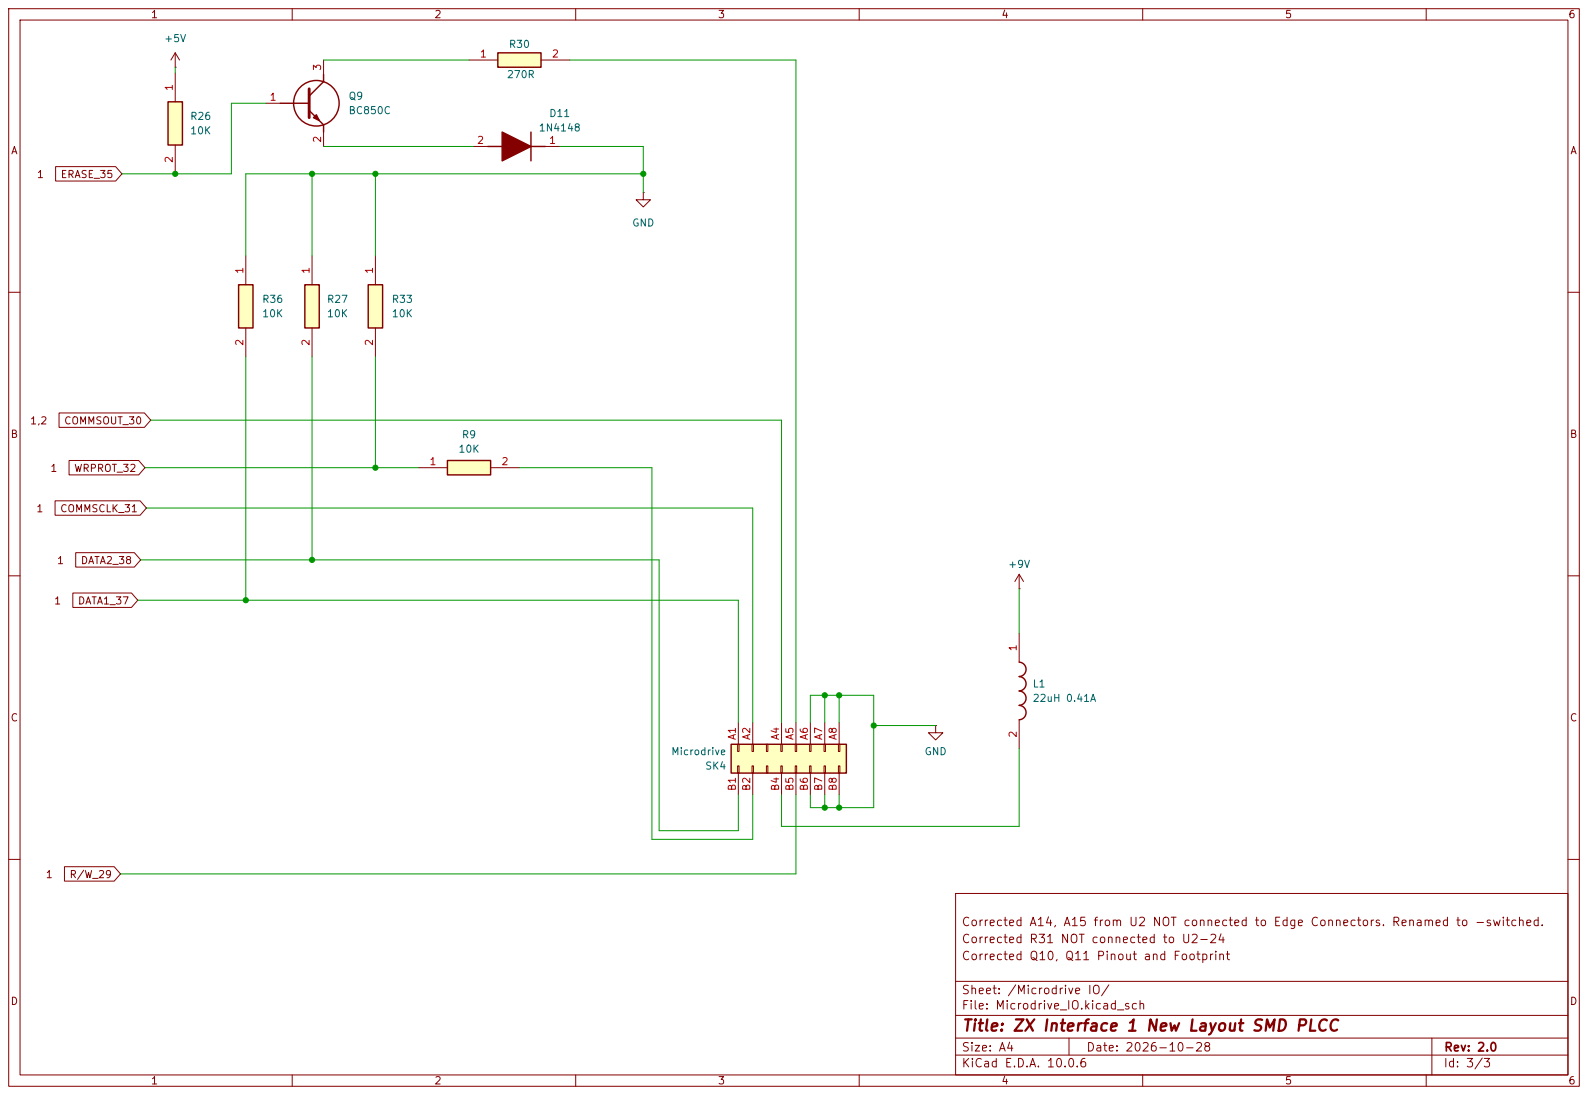
[picture p38: page 3]
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

Sheet: /Microdrive IO/
File: Microdrive_IO.kicad_sch
Title: ZX Interface 1 New Layout SMD PLCC
