liveboxandy/ZX-Interface-1-Renewed-PLCC/ZX Interface 1 New Layout SMD PLCC.kicad_pcb

## KiCad design ZX Interface 1 New Layout SMD PLCC.kicad_pcb (2026-10-28)

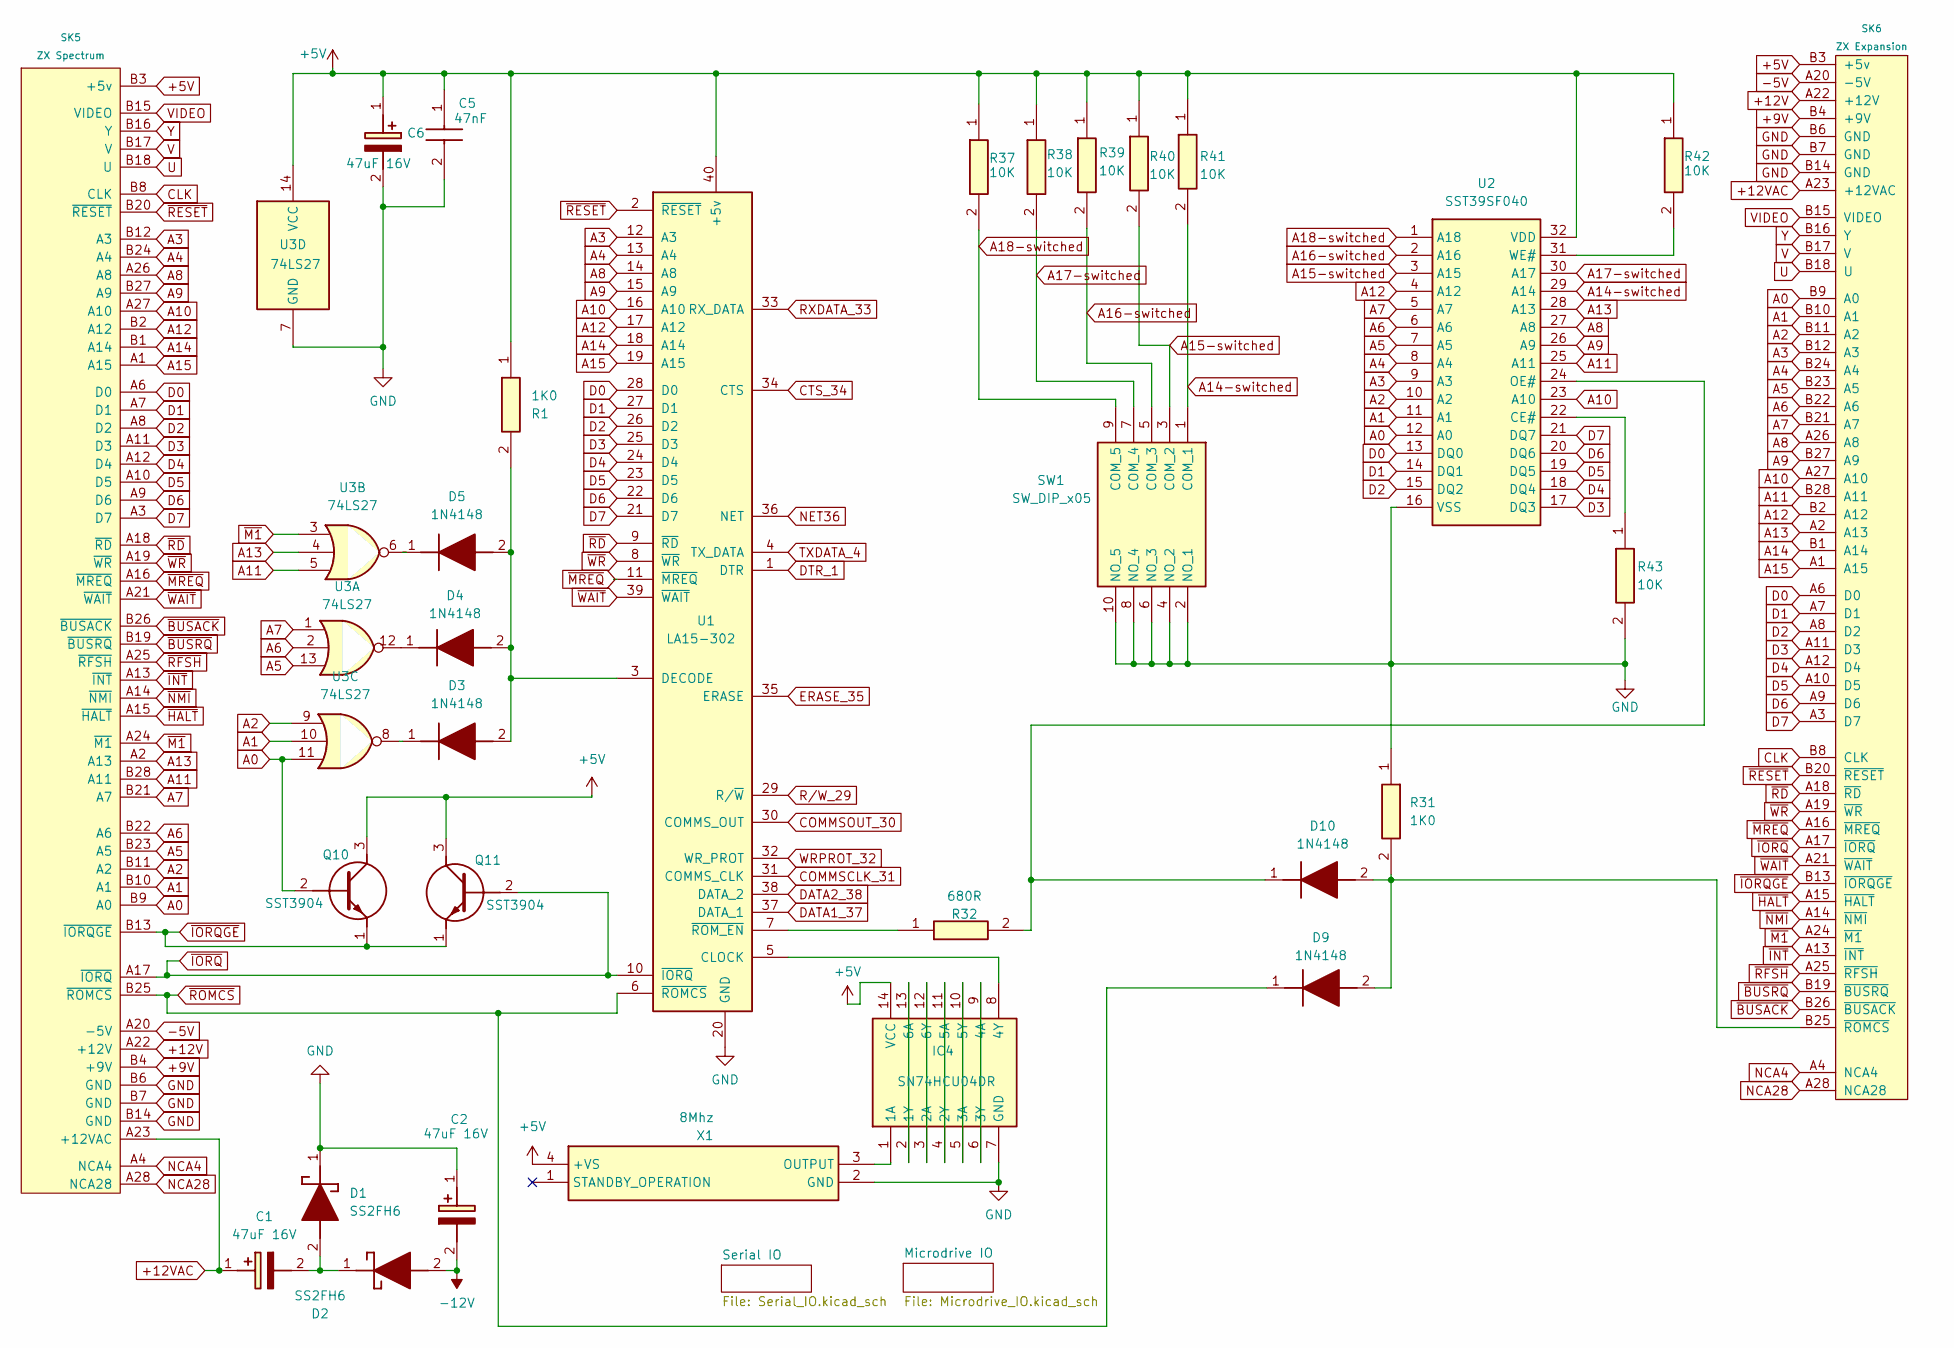
[picture p39: schematic ZX Interface 1 New Layout SMD PLCC.kicad_sch]

Parts:
C1, C2, C6: 47uF 16V; CAPPM7343X310N; Mouser Part Number 74-293D476X9016D2TE3
C5: 47nF; C1206; Mouser Part Number 80-C1206C473K5R
D1, D2: SS2FH6; SODFL3718X108N; Mouser Part Number 78-SS2FH6-M3H
D3, D4, D5, D9, D10: 1N4148; SODFL2512X90N; Mouser Part Number 512-1N4148WS
IC4: SN74HCU04DR; SOIC127P600X175-14N; Mouser Part Number 595-SN74HCU04DR
Q10, Q11: SST3904; SOT95P240X120-3N; Mouser Part Number 755-SST3904HZGT116
R1, R31: 1K0; RESC3216X60N; Mouser Part Number 71-CRCW12061K00FKEAC
R32: 680R; RESC3116X65N; Mouser Part Number 279-CRGH1206F680R
R37, R38, R39, R40, R41, R42, R43: 10K; RESC3116X65N; Mouser Part Number 279-CRG1206F10K
SK5: ZX Spectrum; ZX_Spectrum_BUS_Edge_Connector
SK6: ZX Expansion; ZX_Expansion_BUS_Edge_Connector
SW1: SW_DIP_x05; A6FR5104; Mouser Part Number 653-A6FR-5104
U1: LA15-302; DIP-40_W15.24mm
U2: SST39SF040; MC32PLCC; Mouser Part Number 804-39SF0407CPHE
U3: 74LS27; SOIC127P600X175-14N; Mouser Part Number 595-SN74LS27D
X1: 8Mhz; 830202129201; Mouser Part Number 449-LFSPXO021292BULK

Connections:
+5V: C5.1, C6.1 (+), IC4.14 (VCC), Q10.3 (C), Q11.3 (C), R1.1, R37.1, R38.1, R39.1, R40.1, R41.1, R42.1, SK5.B3 (+5v), SK6.B3 (+5v), U1.40 (+5v), U2.32 (VDD), U3.14 (VCC), X1.4 (+VS); also elsewhere on the board
+9V: SK5.B4 (+9V), SK6.B4 (+9V); also elsewhere on the board
+12V: SK5.A22 (+12V), SK6.A22 (+12V); also elsewhere on the board
+12VAC: C1.1 (+), SK5.A23 (+12VAC), SK6.A23 (+12VAC)
-5V: SK5.A20 (-5V), SK6.A20 (-5V)
-12V: C2.2 (-), D2.2 (A); also elsewhere on the board
A0: Q10.2 (B), SK5.B9 (A0), SK6.B9 (A0), U2.12 (A0), U3.11
A1: SK5.B10 (A1), SK6.B10 (A1), U2.11 (A1), U3.10
A2: SK5.B11 (A2), SK6.B11 (A2), U2.10 (A2), U3.9
A3: SK5.B12 (A3), SK6.B12 (A3), U1.12 (A3), U2.9 (A3)
A4: SK5.B24 (A4), SK6.B24 (A4), U1.13 (A4), U2.8 (A4)
A5: SK5.B23 (A5), SK6.B23 (A5), U2.7 (A5), U3.13
A6: SK5.B22 (A6), SK6.B22 (A6), U2.6 (A6), U3.2
A7: SK5.B21 (A7), SK6.B21 (A7), U2.5 (A7), U3.1
A8: SK5.A26 (A8), SK6.A26 (A8), U1.14 (A8), U2.27 (A8)
A9: SK5.B27 (A9), SK6.B27 (A9), U1.15 (A9), U2.26 (A9)
A10: SK5.A27 (A10), SK6.A27 (A10), U1.16 (A10), U2.23 (A10)
A11: SK5.B28 (A11), SK6.B28 (A11), U2.25 (A11), U3.5
A12: SK5.B2 (A12), SK6.B2 (A12), U1.17 (A12), U2.4 (A12)
A13: SK5.A2 (A13), SK6.A2 (A13), U2.28 (A13), U3.4
A14: SK5.B1 (A14), SK6.B1 (A14), U1.18 (A14)
A14-switched: R41.2, SW1.1 (COM_1), U2.29 (A14)
A15: SK5.A1 (A15), SK6.A1 (A15), U1.19 (A15)
A15-switched: R40.2, SW1.3 (COM_2), U2.3 (A15)
A16-switched: R39.2, SW1.5 (COM_3), U2.2 (A16)
A17-switched: R38.2, SW1.7 (COM_4), U2.30 (A17)
A18-switched: R37.2, SW1.9 (COM_5), U2.1 (A18)
CLK: SK5.B8 (CLK), SK6.B8 (CLK)
COMMSCLK_31: U1.31 (COMMS_CLK); also elsewhere on the board
COMMSOUT_30: U1.30 (COMMS_OUT); also elsewhere on the board
CTS_34: U1.34 (CTS); also elsewhere on the board
D0: SK5.A6 (D0), SK6.A6 (D0), U1.28 (D0), U2.13 (DQ0)
D1: SK5.A7 (D1), SK6.A7 (D1), U1.27 (D1), U2.14 (DQ1)
D2: SK5.A8 (D2), SK6.A8 (D2), U1.26 (D2), U2.15 (DQ2)
D3: SK5.A11 (D3), SK6.A11 (D3), U1.25 (D3), U2.17 (DQ3)
D4: SK5.A12 (D4), SK6.A12 (D4), U1.24 (D4), U2.18 (DQ4)
D5: SK5.A10 (D5), SK6.A10 (D5), U1.23 (D5), U2.19 (DQ5)
D6: SK5.A9 (D6), SK6.A9 (D6), U1.22 (D6), U2.20 (DQ6)
D7: SK5.A3 (D7), SK6.A3 (D7), U1.21 (D7), U2.21 (DQ7)
DATA1_37: U1.37 (DATA_1); also elsewhere on the board
DATA2_38: U1.38 (DATA_2); also elsewhere on the board
DTR_1: U1.1 (DTR); also elsewhere on the board
ERASE_35: U1.35 (ERASE); also elsewhere on the board
GND: C2.1 (+), C5.2, C6.2 (-), D1.1 (K), IC4.7 (GND), R31.1, R43.2, SK5.B6 (GND), SK5.B7 (GND), SK5.B14 (GND), SK6.B6 (GND), SK6.B7 (GND), SK6.B14 (GND), SW1.2 (NO_1), SW1.4 (NO_2), SW1.6 (NO_3), SW1.8 (NO_4), SW1.10 (NO_5), U1.20 (GND), U2.16 (VSS), U3.7 (GND), X1.2 (GND); also elsewhere on the board
NCA4: SK5.A4 (NCA4), SK6.A4 (NCA4)
NCA28: SK5.A28 (NCA28), SK6.A28 (NCA28)
NET36: U1.36 (NET); also elsewhere on the board
unnamed: C1.2 (-), D1.2 (A), D2.1 (K)
unnamed: D3.2 (A), D4.2 (A), D5.2 (A), R1.2, U1.3 (DECODE)
unnamed: D3.1 (K), U3.8
unnamed: D4.1 (K), U3.12
unnamed: D5.1 (K), U3.6
unnamed: D9.2 (A), D10.2 (A), R31.2, SK6.B25 (~ROMCS)
unnamed: D10.1 (K), R32.2, U2.24 (OE#)
unnamed: IC4.1 (1A), X1.3 (OUTPUT)
unnamed: IC4.2 (1Y), IC4.13 (6A)
unnamed: IC4.3 (2A), IC4.12 (6Y)
unnamed: IC4.4 (2Y), IC4.11 (5A)
unnamed: IC4.5 (3A), IC4.10 (5Y)
unnamed: IC4.6 (3Y), IC4.9 (4A)
unnamed: IC4.8 (4Y), U1.5 (CLOCK)
unnamed: R32.1, U1.7 (~ROM_EN)
unnamed: R43.1, U2.22 (CE#)
unnamed: R42.2, U2.31 (WE#)
RXDATA_33: U1.33 (RX_DATA); also elsewhere on the board
R/W_29: U1.29 (R/~W); also elsewhere on the board
TXDATA_4: U1.4 (TX_DATA); also elsewhere on the board
U: SK5.B18 (U), SK6.B18 (U)
V: SK5.B17 (V), SK6.B17 (V)
VIDEO: SK5.B15 (VIDEO), SK6.B15 (VIDEO)
WRPROT_32: U1.32 (WR_PROT); also elsewhere on the board
Y: SK5.B16 (Y), SK6.B16 (Y)
~BUSACK: SK5.B26 (~BUSACK), SK6.B26 (~BUSACK)
~BUSRQ: SK5.B19 (~BUSRQ), SK6.B19 (~BUSRQ)
~HALT: SK5.A15 (~HALT), SK6.A15 (~HALT)
~INT: SK5.A13 (~INT), SK6.A13 (~INT)
~IORQGE: Q10.1 (E), Q11.1 (E), SK5.B13 (~IORQGE), SK6.B13 (~IORQGE)
~IORQ: Q11.2 (B), SK5.A17 (~IORQ), SK6.A17 (~IORQ), U1.10 (~IORQ)
~M1: SK5.A24 (~M1), SK6.A24 (~M1), U3.3
~MREQ: SK5.A16 (~MREQ), SK6.A16 (~MREQ), U1.11 (~MREQ)
~NMI: SK5.A14 (~NMI), SK6.A14 (~NMI)
~RD: SK5.A18 (~RD), SK6.A18 (~RD), U1.9 (~RD)
~RESET: SK5.B20 (~RESET), SK6.B20 (~RESET), U1.2 (~RESET)
~RFSH: SK5.A25 (~RFSH), SK6.A25 (~RFSH)
~ROMCS: D9.1 (K), SK5.B25 (~ROMCS), U1.6 (~ROMCS)
~WAIT: SK5.A21 (~WAIT), SK6.A21 (~WAIT), U1.39 (~WAIT)
~WR: SK5.A19 (~WR), SK6.A19 (~WR), U1.8 (~WR)

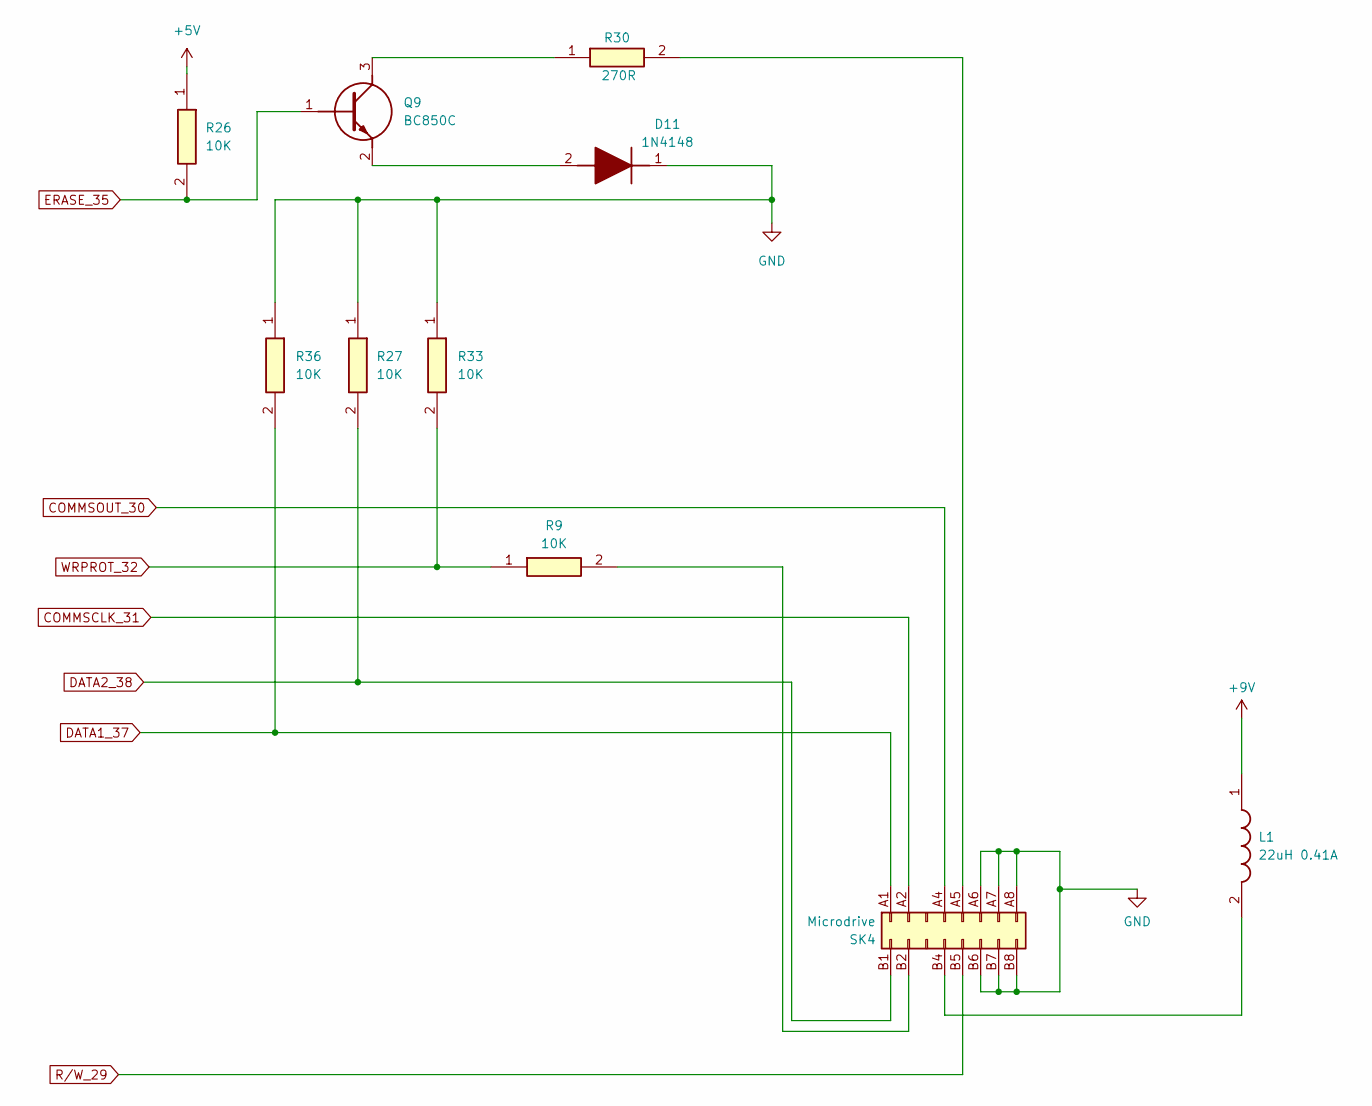
[picture p40: schematic Microdrive_IO.kicad_sch, ZX Interface 1 New Layout SMD PLCC]

Parts:
D11: 1N4148; SODFL2512X90N; Mouser Part Number 512-1N4148WS
L1: 22uH 0.41A; LQH2MCN100K02L; Mouser Part Number 81-LQH2MPN220MGRL
Q9: BC850C; BC850C215; Mouser Part Number 771-BC850C-T/R
R9, R26, R27, R33, R36: 10K; RESC3116X65N; Mouser Part Number 279-CRG1206F10K
R30: 270R; RESC3216X60N; Mouser Part Number 71-CRCW1206-270-E3
SK4: Microdrive; ZX_MD_Edge_Connector

Connections:
+5V: R26.1; also elsewhere on the board
+9V: L1.1; also elsewhere on the board
COMMSCLK_31: SK4.A2; also elsewhere on the board
COMMSOUT_30: SK4.A4; also elsewhere on the board
DATA1_37: R36.2, SK4.A1; also elsewhere on the board
DATA2_38: R27.2, SK4.B1; also elsewhere on the board
ERASE_35: Q9.1 (B), R26.2; also elsewhere on the board
GND: D11.1 (K), R27.1, R33.1, R36.1, SK4.A6, SK4.A7, SK4.A8, SK4.B6, SK4.B7, SK4.B8; also elsewhere on the board
unnamed: D11.2 (A), Q9.2 (E)
unnamed: Q9.3 (C), R30.1
unnamed: R30.2, SK4.A5
unnamed: R9.2, SK4.B2
unnamed: L1.2, SK4.B4
R/W_29: SK4.B5; also elsewhere on the board
WRPROT_32: R9.1, R33.2; also elsewhere on the board

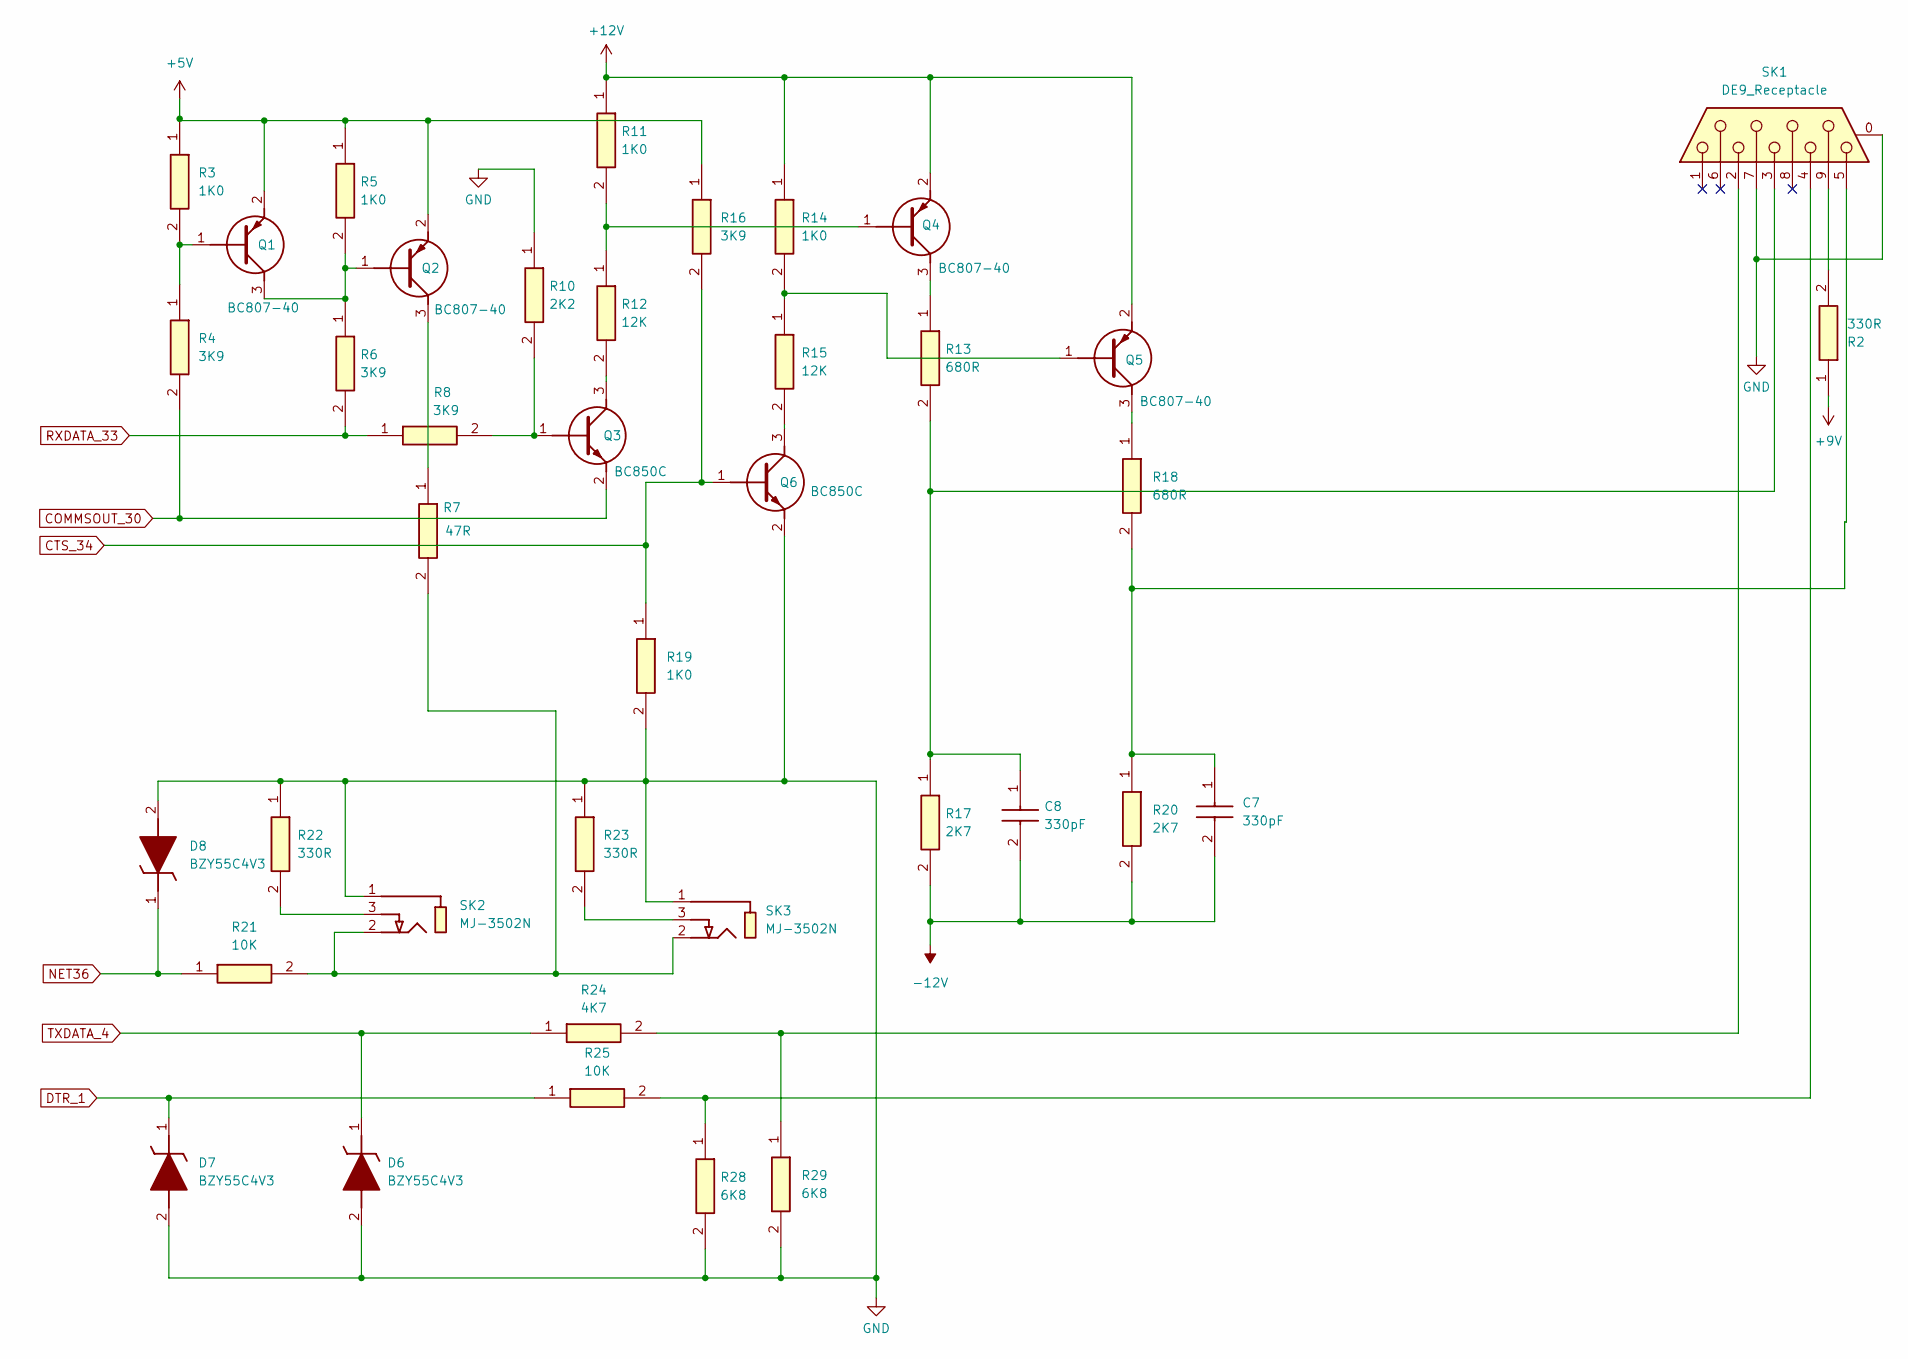
[picture p41: schematic Serial_IO.kicad_sch, ZX Interface 1 New Layout SMD PLCC]

Parts:
C7, C8: 330pF; CAPC3317X75N; Mouser Part Number 810-C3216C0G2J331J
D6, D7, D8: BZY55C4V3; DIOC2012X85N; Manufacturer_Part_Number BZY55C4V3 RBG; Mouser Part Number 821-BZY55C4V3RBG
Q1, Q2, Q4, Q5: BC807-40; SOT95P230X110-3N; Mouser Part Number 771-BC807-40-T/R
Q3, Q6: BC850C; BC850C215; Mouser Part Number 771-BC850C-T/R
R2, R22, R23: 330R; RESC3116X65N; Mouser Part Number 279-CRGH1206F330R
R3, R5, R11, R14, R19: 1K0; RESC3216X60N; Mouser Part Number 71-CRCW12061K00FKEAC
R4, R6, R8, R16: 3K9; RESC3216X60N; Mouser Part Number 71-CRCW1206-3.9K-E3
R7: 47R; RCC1206_e3; Mouser Part Number 71-RCC120647R0FKEA
R10: 2K2; RESC3216X60N; Mouser Part Number 71-CRCW1206-2.2K-E3
R12, R15: 12K; RESC3216X60N; Mouser Part Number 71-CRCW120612K4FKEAC
R13, R18: 680R; RESC3116X65N; Mouser Part Number 279-CRGH1206F680R
R17, R20: 2K7; RESC3116X65N; Mouser Part Number 279-CRGH1206F2K7
R21, R25: 10K; RESC3116X65N; Mouser Part Number 279-CRG1206F10K
R24: 4K7; RESC3116X65N; Manufacturer_Part_Number CRGS1206J4K7
R28, R29: 6K8; RESC3116X65N; Mouser Part Number 279-CRG1206F6K8
SK1: DE9_Receptacle; DSUB-9_Female_Horizontal_P2.77x2.84mm_EdgePinOffset4.94mm_H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
SK2, SK3: MJ-3502N; MJ3502N; Mouser Part Number 490-MJ-3502N

Connections:
+5V: Q1.2 (E), Q2.2 (E), R3.1, R5.1, R16.1; also elsewhere on the board
+9V: R2.1; also elsewhere on the board
+12V: Q4.2 (E), Q5.2 (E), R11.1, R14.1; also elsewhere on the board
-12V: C7.2, C8.2, R17.2, R20.2; also elsewhere on the board
COMMSOUT_30: Q3.2 (E), R4.2; also elsewhere on the board
CTS_34: Q6.1 (B), R16.2, R19.1; also elsewhere on the board
DTR_1: D7.1 (K), R25.1; also elsewhere on the board
GND: D6.2 (A), D7.2 (A), D8.2 (A), Q6.2 (E), R10.1, R19.2, R22.1, R23.1, R28.2, R29.2, SK1.0 (PAD), SK1.7, SK2.1, SK3.1; also elsewhere on the board
NET36: D8.1 (K), R21.1; also elsewhere on the board
unnamed: C7.1, R18.2, R20.1, SK1.5
unnamed: C8.1, R13.2, R17.1, SK1.3
unnamed: Q1.1 (B), R3.2, R4.1
unnamed: Q1.3 (C), Q2.1 (B), R5.2, R6.1
unnamed: Q2.3 (C), R7.1
unnamed: Q3.1 (B), R8.2, R10.2
unnamed: Q3.3 (C), R12.2
unnamed: Q4.1 (B), R11.2, R12.1
unnamed: Q4.3 (C), R13.1
unnamed: Q5.1 (B), R14.2, R15.1
unnamed: Q5.3 (C), R18.1
unnamed: Q6.3 (C), R15.2
unnamed: R2.2, SK1.9
unnamed: R7.2, R21.2, SK2.2, SK3.2
unnamed: R22.2, SK2.3
unnamed: R23.2, SK3.3
unnamed: R24.2, R29.1, SK1.2
unnamed: R25.2, R28.1, SK1.4
RXDATA_33: R6.2, R8.1; also elsewhere on the board
TXDATA_4: D6.1 (K), R24.1; also elsewhere on the board

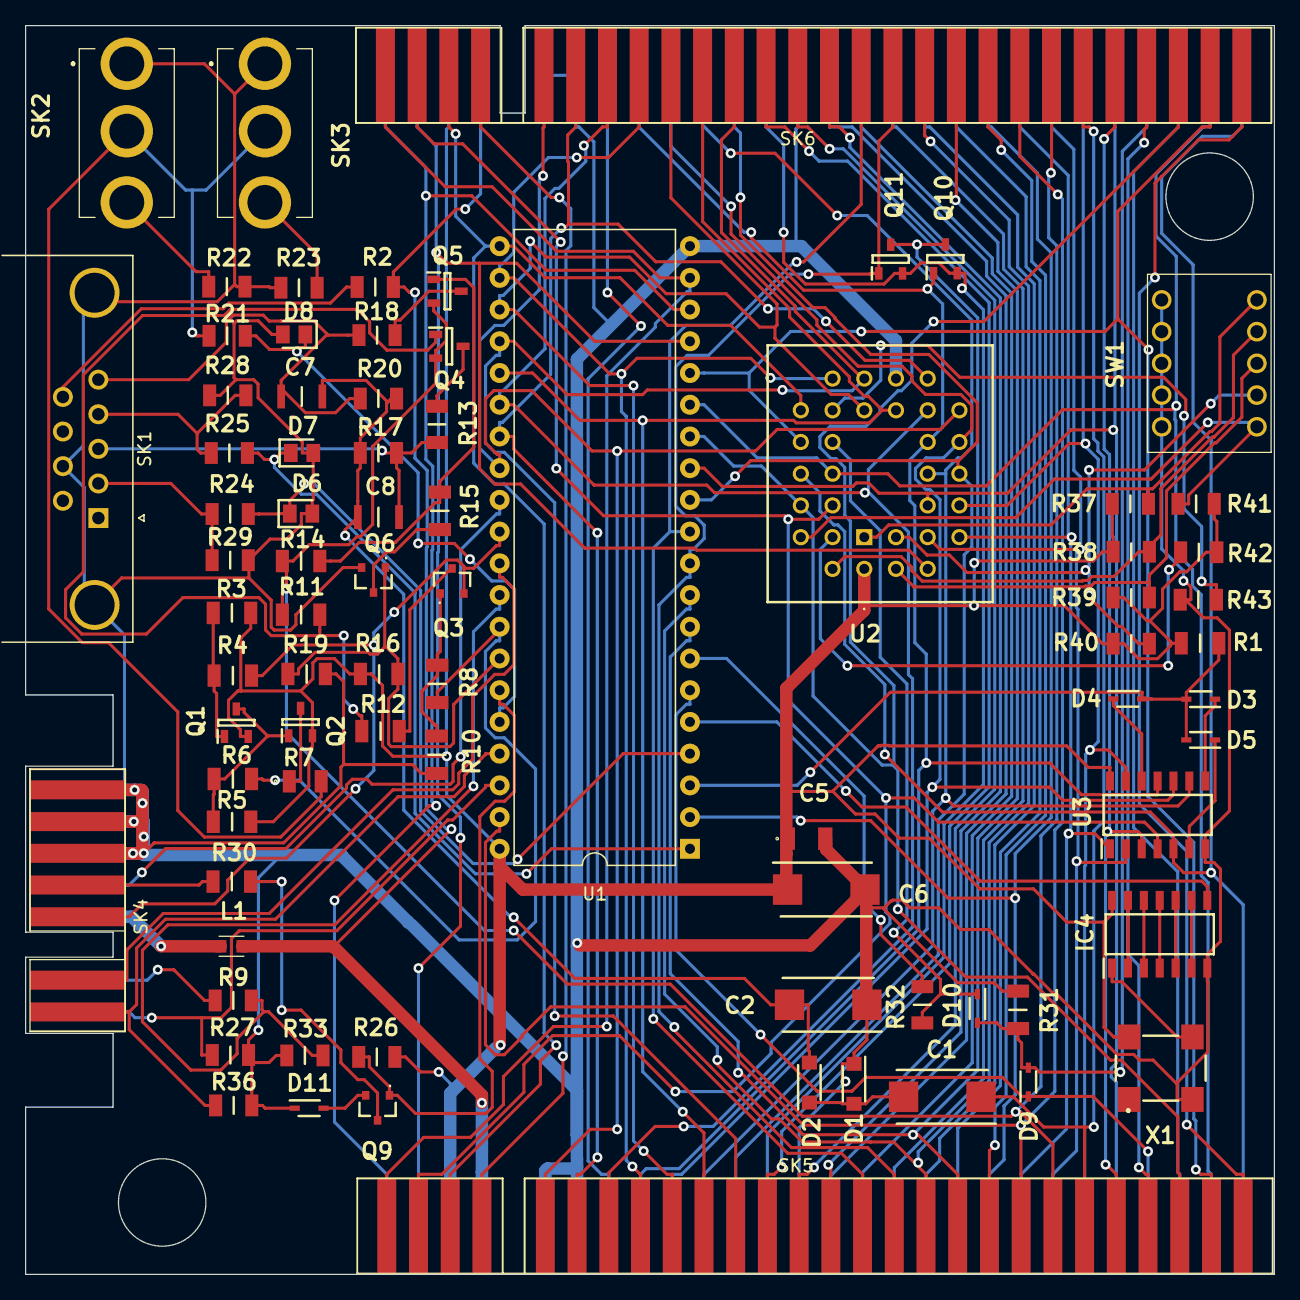
[picture p42: board ZX Interface 1 New Layout SMD PLCC.kicad_pcb from above]

Board: 2 copper layers, 100.0 x 100.0 mm, 80 parts (0 on the bottom side), 110 nets.
