liveboxandy/ZX-Interface-1-Renewed-PLCC/(notices)

Notices in the files:
STPS/DIP-32_W15.24mm_Socket.step:
Copyright (C) 2017, Terje Io
This program is free software: you can redistribute it and/or modify
it under the terms of the GNU General Public License as published by
the Free Software Foundation, either version 3 of the License, or
any later version.
itself might be covered by the GNU General Public License.
STPS/DIP-40_W15.24mm.step:
Copyright (C) 2017, your name
STPS/DSUB-9_Female_Horizontal_P2.77x2.84mm_EdgePinOffset4.94mm_Housed_MountingHolesOffset7.48mm.step:
Copyright (C) 2020, kicad StepUp
This work is licensed under the [Creative Commons CC-BY-SA 4.0 License](https://creativecommons.org/licenses/by-sa/4.0/legalcode),
with the following exception:
To the extent that the creation of electronic designs that use 'Licensed Material' can be considered to be 'Adapted Material',
You are free to use the library data in your own projects without the obligation to share your project files under this or any other license agreement.
